sudhanshuksingh/Arduino-28-Pins-PCB/README.md

# Arduino-28-Pins-PCB
Contains all the important files related to my open source Arduino 28 Pins PCB Design Course
