sudhanshuksingh/Arduino-28-Pins-PCB/Certificate of Completion.pdf

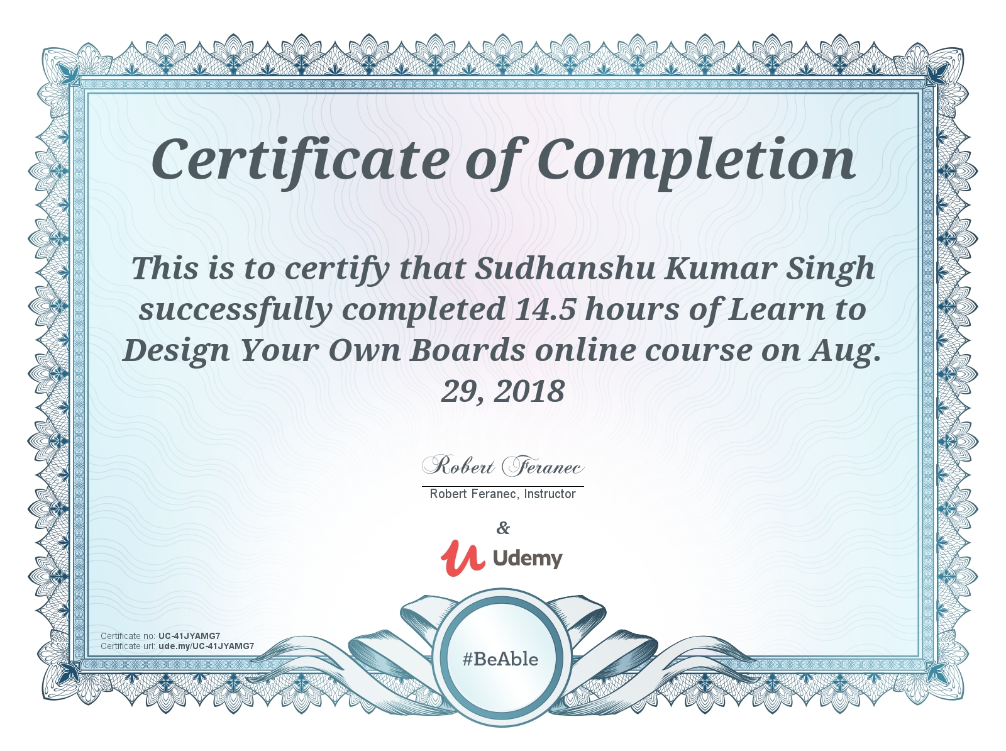
[picture p1: page 1]
