sudhanshuksingh/Arduino-28-Pins-PCB/Project Outputs for 28Pins_Project_V1I1/BOM/BOM Grouped Reference - 28Pins V1I1 FIXED 5V.xlsx

Sheet: Part List Report
 | Component reference list (grouped) |  |  |  | <Parameter Project not found>
 | Source Data From: |  | 28Pins_Project_V1I1.PrjPCB |  |  | Contact: |  | Generated by:
 | Project: |  | 28Pins_Project_V1I1.PrjPCB
 | Variant: |  | FIXED 5V |  |  |  |  | FEDEVEL
 | Report Date: |  | 29-08-2018 | 16:36:12 |  |  |  | http://www.fedevel.com
 | Print Date: |  | 2018-08-29 | 16:36:29
# | Designator | Quantity | Comment | Description | Manufacturer 1 | Manufacturer Part Number 1 | Case/Package | Supplier 1 | Supplier Part Number 1
1 | C1, C2 | 2 | 100u / 10V | Cap Aluminum Lytic 100uF 10V 20% (5 X 5.4mm) SMD 50mA 1000h 85C Automotive T/R | Panasonic (https://octopart-clicks.com/click/altium?sku=PCE3867CT-ND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) | EEE-1AA101WR (https://octopart-clicks.com/click/altium?sku=PCE3867CT-ND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) | Radial | Digi-Key | PCE3867CT-ND (https://octopart-clicks.com/click/altium?sku=PCE3867CT-ND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)
2 | C3, C12, C13, C19, C21, C22, C34 | 7 | 10uF / 16V | CAP CER 10UF 16V X5R 0805 | TDK (https://octopart-clicks.com/click/altium?sku=445-4115-1-ND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) | C2012X5R1C106M125AC (https://octopart-clicks.com/click/altium?sku=445-4115-1-ND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) | 0805 | Digi-Key | 445-4115-1-ND (https://octopart-clicks.com/click/altium?sku=445-4115-1-ND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)
3 | C4, C5, C6, C8, C11, C14, C15, C16, C17, C20, C23, C24, C26, C28, C29, C30, C31, C32, C33 | 19 | 100n | CAP CER 0.1UF 50V X7R 0805 | TDK (https://octopart-clicks.com/click/altium?sku=445-7534-1-ND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) | C2012X7R1H104K085AA (https://octopart-clicks.com/click/altium?sku=445-7534-1-ND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) | 0805 | Digi-Key | 445-7534-1-ND (https://octopart-clicks.com/click/altium?sku=445-7534-1-ND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)
4 | C7 | 1 | 1uf / 25V | CAP CER 1UF 25V X5R 0805 | TDK (https://octopart-clicks.com/click/altium?sku=445-1419-1-ND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) | C2012X5R1E105K125AA (https://octopart-clicks.com/click/altium?sku=445-1419-1-ND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) | 0805 | Digi-Key | 445-1419-1-ND (https://octopart-clicks.com/click/altium?sku=445-1419-1-ND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)
5 | C9, C10, C25, C27 | 4 | 18p | CAP CER 18PF 50V NP0 0805 | KEMET (https://octopart-clicks.com/click/altium?sku=399-1112-1-ND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) | C0805C180J5GAC-TU (https://octopart-clicks.com/click/altium?sku=399-1112-1-ND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) | 0805 | Digi-Key | 399-1112-1-ND (https://octopart-clicks.com/click/altium?sku=399-1112-1-ND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)
6 | D1 | 1 | Green | LED GREEN DIFFUSED 0603 SMD | Osram Opto (https://octopart-clicks.com/click/altium?sku=475-2709-1-ND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) | Q65110A1746 (https://octopart-clicks.com/click/altium?sku=475-2709-1-ND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) | 0603 | Digi-Key | 475-2709-1-ND (https://octopart-clicks.com/click/altium?sku=475-2709-1-ND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)
7 | D2, D3, D4 | 3 | Orange | LED ORANGE DIFFUSED 0603 SMD | Osram Opto (https://octopart-clicks.com/click/altium?sku=475-2740-1-ND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) | Q65110A1747 (https://octopart-clicks.com/click/altium?sku=475-2740-1-ND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) | 0603 | Digi-Key | 475-2740-1-ND (https://octopart-clicks.com/click/altium?sku=475-2740-1-ND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)
8 | D5, D6 | 2 | BAT54HT1G | DIODE SCHOTTKY 30V 200MA SOD323 | ON Semiconductor (https://octopart-clicks.com/click/altium?sku=BAT54HT1GOSCT-ND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) | BAT54HT1G.. (https://octopart-clicks.com/click/altium?sku=BAT54HT1GOSCT-ND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) |  | Digi-Key | BAT54HT1GOSCT-ND (https://octopart-clicks.com/click/altium?sku=BAT54HT1GOSCT-ND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)
9 | FB1, FB2, FB3 | 3 | MPZ2012S601AT000 | TDK MPZ2012S601AT000 FERRITE BEAD, 0.1OHM, 2A, 0805, FULL REEL | TDK (https://octopart-clicks.com/click/altium?sku=445-2206-1-ND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) | MPZ2012S601AT000 (https://octopart-clicks.com/click/altium?sku=445-2206-1-ND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) | 0805 | Digi-Key | 445-2206-1-ND (https://octopart-clicks.com/click/altium?sku=445-2206-1-ND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)
10 | J1, J3 | 2 | HDR FMALE 1x8 2.54mm | Headers & Wire Housings 8 PIN SIL VERTICAL SOCKET GOLD+TIN | Harwin (https://octopart-clicks.com/click/altium?sku=952-1823-ND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) | M20-7820842 (https://octopart-clicks.com/click/altium?sku=952-1823-ND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) | SIL | Digi-Key | 952-1823-ND (https://octopart-clicks.com/click/altium?sku=952-1823-ND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)
11 | J2 | 1 | HDE FMALE 1x6 2.54mm | Headers & Wire Housings 6 PIN SIL VERTICAL SOCKET TIN | Harwin (https://octopart-clicks.com/click/altium?sku=952-1809-ND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) | M20-7820646 (https://octopart-clicks.com/click/altium?sku=952-1809-ND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) | SIL | Digi-Key | 952-1809-ND (https://octopart-clicks.com/click/altium?sku=952-1809-ND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)
12 | J4 | 1 | HDR FMALE 1x10 2.54mm | Headers & Wire Housings 10 PIN SIL VERTICAL SOCKET TIN | Harwin (https://octopart-clicks.com/click/altium?sku=952-1847-ND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) | M20-7821046 (https://octopart-clicks.com/click/altium?sku=952-1847-ND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) | SIL | Digi-Key | 952-1847-ND (https://octopart-clicks.com/click/altium?sku=952-1847-ND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)
13 | J5, J6 | 2 | HDR 2x3 | 6 Positions Header, Unshrouded Connector 0.100" (2.54mm) Through Hole Gold or Gold, GXT™ | Amphenol FCI (https://octopart-clicks.com/click/altium?sku=609-3393-ND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) | 67997-106HLF (https://octopart-clicks.com/click/altium?sku=609-3393-ND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) |  | Digi-Key | 609-3393-ND (https://octopart-clicks.com/click/altium?sku=609-3393-ND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)
14 | J7 | 1 | 10118193-0001LF | USB - micro B USB 2.0 Receptacle Connector 5 Position Surface Mount, Right Angle, Horizontal | Amphenol FCI (https://octopart-clicks.com/click/altium?sku=609-4616-1-ND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) | 10118193-0001LF (https://octopart-clicks.com/click/altium?sku=609-4616-1-ND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) |  | Digi-Key | 609-4616-1-ND (https://octopart-clicks.com/click/altium?sku=609-4616-1-ND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)
15 | JP1 | 1 | HDR 1x3 | 3 Positions Header, Unshrouded Connector 0.100" (2.54mm) Through Hole Gold or Gold, GXT™ | Amphenol FCI (https://octopart-clicks.com/click/altium?sku=609-3461-ND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) | 68000-103HLF (https://octopart-clicks.com/click/altium?sku=609-3461-ND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) |  | Digi-Key | 609-3461-ND (https://octopart-clicks.com/click/altium?sku=609-3461-ND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)
16 | JP3 | 1 | HDR 1x4 | 4 Positions Header, Unshrouded Connector 0.100" (2.54mm) Through Hole Gold or Gold, GXT™ | Amphenol FCI (https://octopart-clicks.com/click/altium?sku=609-3402-ND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) | 68001-204HLF (https://octopart-clicks.com/click/altium?sku=609-3402-ND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) |  | Digi-Key | 609-3402-ND (https://octopart-clicks.com/click/altium?sku=609-3402-ND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)
17 | L1 | 1 | 2u2 / 2A | Inductor Chip Wirewound 2.2uH 20% 100KHz 1.13A 80mOhm DCR 1210 T/R | KEMET (https://octopart-clicks.com/click/altium?sku=399-9598-1-ND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) | L1210R2R2MDWIT (https://octopart-clicks.com/click/altium?sku=399-9598-1-ND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) | 1210 | Digi-Key | 399-9598-1-ND (https://octopart-clicks.com/click/altium?sku=399-9598-1-ND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)
18 | LINK1, LINK2 | 2 | LINK | CONN JUMPER SHORTING .100" GOLD | Sullins (https://octopart-clicks.com/click/altium?sku=S9337-ND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) | QPC02SXGN-RC (https://octopart-clicks.com/click/altium?sku=S9337-ND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) | 100 | Digi-Key | S9337-ND (https://octopart-clicks.com/click/altium?sku=S9337-ND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)
19 | R1 | 1 | 100k | RES SMD 100K OHM 1% 1/8W 0805 | Yageo (https://octopart-clicks.com/click/altium?sku=YAG3359CT-ND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) | RT0805FRE07100KL (https://octopart-clicks.com/click/altium?sku=YAG3359CT-ND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) | 0805 | Digi-Key | YAG3359CT-ND (https://octopart-clicks.com/click/altium?sku=YAG3359CT-ND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)
20 | R2, R3, R15, R17, R22 | 5 | 560R | RES SMD 560 OHM 1% 1/8W 0805 | Yageo Phycomp (https://octopart-clicks.com/click/altium?sku=311-560CRCT-ND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) | RC0805FR-07560RL (https://octopart-clicks.com/click/altium?sku=311-560CRCT-ND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) | 0805 | Digi-Key | 311-560CRCT-ND (https://octopart-clicks.com/click/altium?sku=311-560CRCT-ND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)
21 | R4, R14, R18, R19, R20, R21 | 6 | 10k | RES SMD 10K OHM 1% 1/8W 0805 | Yageo (https://octopart-clicks.com/click/altium?sku=311-10.0KCRCT-ND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) | RC0805FR-0710KL (https://octopart-clicks.com/click/altium?sku=311-10.0KCRCT-ND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) | 0805 | Digi-Key | 311-10.0KCRCT-ND (https://octopart-clicks.com/click/altium?sku=311-10.0KCRCT-ND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)
22 | R5, R6, R7, R13, R23, R24, R25 | 7 | 22R | RES SMD 22 OHM 1% 1/8W 0805 | Yageo (https://octopart-clicks.com/click/altium?sku=311-22.0CRCT-ND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) | RC0805FR-0722RL (https://octopart-clicks.com/click/altium?sku=311-22.0CRCT-ND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) | 0805 | Digi-Key | 311-22.0CRCT-ND (https://octopart-clicks.com/click/altium?sku=311-22.0CRCT-ND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)
23 | R8, R27 | 2 | 0R | YAGEO RC0805JR-070RL RES, THICK FILM, 0R, 0.125W, 0805 | Yageo (https://octopart-clicks.com/click/altium?sku=311-0.0ARCT-ND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) | RC0805JR-070RL (https://octopart-clicks.com/click/altium?sku=311-0.0ARCT-ND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) | 0805 | Digi-Key | 311-0.0ARCT-ND (https://octopart-clicks.com/click/altium?sku=311-0.0ARCT-ND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)
24 | R9, R16 | 2 | 1M | Yageo RC0805 Series Thick Film Surface Mount Resistor 0805 Case 1MO ±1% 0.125W ±100ppm/°C | Yageo (https://octopart-clicks.com/click/altium?sku=311-1.00MCRCT-ND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) | RC0805FR-071ML (https://octopart-clicks.com/click/altium?sku=311-1.00MCRCT-ND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) | 0805 | Digi-Key | 311-1.00MCRCT-ND (https://octopart-clicks.com/click/altium?sku=311-1.00MCRCT-ND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)
25 | R10, R11, R12 | 3 | 1k | RES SMD 1K OHM 1% 1/8W 0805 | Yageo (https://octopart-clicks.com/click/altium?sku=311-1.00KCRCT-ND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) | RC0805FR-071KL (https://octopart-clicks.com/click/altium?sku=311-1.00KCRCT-ND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) | 0805 | Digi-Key | 311-1.00KCRCT-ND (https://octopart-clicks.com/click/altium?sku=311-1.00KCRCT-ND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)
26 | SCKT FOR U1 | 1 | 28-DIP Socket | SOCKET IC OPEN FRAME 28POS .3" | 3M (https://octopart-clicks.com/click/altium?sku=3M5480-ND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) | 4828-3004-CP (https://octopart-clicks.com/click/altium?sku=3M5480-ND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) |  | Digi-Key | 3M5480-ND (https://octopart-clicks.com/click/altium?sku=3M5480-ND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)
27 | SW1, SW2 | 2 | 1825910-6 | Switch Push Button OFF (ON) SPST Round Button 0.05A 24VDC Momentary Contact PC Pins Thru-Hole | TE Connectivity Alcoswitch (https://octopart-clicks.com/click/altium?manufacturer=TE%20Connectivity%20Alcoswitch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) | 1825910-6 (https://octopart-clicks.com/click/altium?manufacturer=TE%20Connectivity%20Alcoswitch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) |  | Digi-Key | 450-1650-ND (https://octopart-clicks.com/click/altium?manufacturer=TE%20Connectivity%20Alcoswitch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)
28 | U1 | 1 | ATMEGA328P-PU | ATMEL ATMEGA328P-PU 8 Bit Microcontroller, Low Power High Performance, ATmega, 20 MHz, 32 KB, 2 KB, 28 Pins, DIP | Microchip (https://octopart-clicks.com/click/altium?sku=ATMEGA328P-PU-ND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) | ATMEGA328P-PU (https://octopart-clicks.com/click/altium?sku=ATMEGA328P-PU-ND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) | PDIP | Digi-Key | ATMEGA328P-PU-ND (https://octopart-clicks.com/click/altium?sku=ATMEGA328P-PU-ND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)
29 | U2 | 1 | ATMEGA16U2-AU | ATMEL ATMEGA16U2-AU MCU, 8BIT, MEGAAVR, 16MHZ, TQFP-32 | Microchip (https://octopart-clicks.com/click/altium?sku=ATMEGA16U2-AU-ND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) | ATMEGA16U2-AU (https://octopart-clicks.com/click/altium?sku=ATMEGA16U2-AU-ND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) | A | Digi-Key | ATMEGA16U2-AU-ND (https://octopart-clicks.com/click/altium?sku=ATMEGA16U2-AU-ND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)
30 | U3 | 1 | TL1963A-33DCQR | IC REG LDO 3.3V 1.5A SOT223-6 | Texas Instruments (https://octopart-clicks.com/click/altium?sku=296-24534-1-ND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) | TL1963A-33DCQR (https://octopart-clicks.com/click/altium?sku=296-24534-1-ND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) | SOT-223 | Digi-Key | 296-24534-1-ND (https://octopart-clicks.com/click/altium?sku=296-24534-1-ND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)
31 | U4, U5, U6, U7 | 4 | SN74AHC1G09DBVR | IC GATE AND 1CH 2-INP SOT-23-5 | Texas Instruments (https://octopart-clicks.com/click/altium?sku=296-29202-1-ND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) | SN74AHC1G09DBVR (https://octopart-clicks.com/click/altium?sku=296-29202-1-ND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) | SOT-23 | Digi-Key | 296-29202-1-ND (https://octopart-clicks.com/click/altium?sku=296-29202-1-ND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)
32 | Y1, Y2 | 2 | ABM7-16.000MHZ-D2Y-T | Crystals 16.0MHz 20ppm 18pF -40C+85C | Abracon (https://octopart-clicks.com/click/altium?sku=535-9840-1-ND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) | ABM7-16.000MHZ-D2Y-T (https://octopart-clicks.com/click/altium?sku=535-9840-1-ND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) | CSMD | Digi-Key | 535-9840-1-ND (https://octopart-clicks.com/click/altium?sku=535-9840-1-ND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)
33 | Z1, Z2 | 2 | CG0603MLC-05E | BOURNS CG0603MLC-05E TVS Varistor, AEC-Q200 ChipGuard MLC Series, 8 V, 5 V, 20 V, 0603 [1608 Metric], ESD Protector | Bourns (https://octopart-clicks.com/click/altium?sku=CG0603MLC-05ECT-ND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) | CG0603MLC-05E (https://octopart-clicks.com/click/altium?sku=CG0603MLC-05ECT-ND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) | 0603 | Digi-Key | CG0603MLC-05ECT-ND (https://octopart-clicks.com/click/altium?sku=CG0603MLC-05ECT-ND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)
Approved |  |  |  |  | Notes

Sheet: Project Information
Project Full Path | C:\Users\admin\Downloads\Altium Design Course\Udemy\28 Pins\Design Files\V1I1\28Pins_Project_V1I1.PrjPCB
Project Filename | 28Pins_Project_V1I1.PrjPCB
Variant Name | FIXED 5V
Data-Source Filename | 28Pins_Project_V1I1.PrjPCB
Data-Source Full Path | C:\Users\admin\Downloads\Altium Design Course\Udemy\28 Pins\Design Files\V1I1\28Pins_Project_V1I1.PrjPCB
Title | 28Pins_Project_V1I1.PrjPCB
Total Quantity | 94
Report Time | 16:36:12
Report Date | 29-08-2018
Report Date & Tine | 29-08-2018 16:36:12
Output Name | 28 Pins Component Grouped BOM
Output Type | BOM_PartType
Output Generator Name | BOM
Output Generator Description | Bill of Materials
