sudhanshuksingh/Arduino-28-Pins-PCB/Project Outputs for 28Pins_Project_V1I1/BOM/BOM Purchasing - 28Pins V1I1 - 5V and 3V3.xls

Sheet: Part List Report
 | Component list |  |  | 28Pins BOM Purchasing For Variant [5V/3V3] of Project [28Pins_Project_V1I1.PrjPCB] (No PCB Document Selected)
 | Source Data From: | 28Pins_Project_V1I1.PrjPCB |  |  | Contact: |  |  |  | Generated by:
 | Project: | 28Pins_Project_V1I1.PrjPCB
 | Variant: | 5V/3V3 |  |  |  |  |  |  | FEDEVEL
 | Report Date: | 29-08-2018 | 15:41:09 |  |  |  |  |  | http://www.fedevel.com
 | Print Date: | 2018-08-29 | 15:45:27
# | #Column Name Error:Category | Manufacturer 1 | Manufacturer Part Number 1 | #Column Name Error:Package / Case | Description | Quantity | Supplier 1 | Supplier Part Number 1 | Supplier Order Qty 1 | Supplier Stock 1 | Supplier Unit Price 1 | Supplier Subtotal 1 | Supplier Currency 1
1 |  | Amphenol FCI (https://octopart-clicks.com/click/altium?sku=609-3461-ND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) | 68000-103HLF (https://octopart-clicks.com/click/altium?sku=609-3461-ND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) |  | 3 Positions Header, Unshrouded Connector 0.100" (2.54mm) Through Hole Gold or Gold, GXT™ | 2 | Digi-Key | 609-3461-ND (https://octopart-clicks.com/click/altium?sku=609-3461-ND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) | 2000 | 27050 | 0.14 | 270.56 | USD
2 |  | Amphenol FCI (https://octopart-clicks.com/click/altium?sku=609-3402-ND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) | 68001-204HLF (https://octopart-clicks.com/click/altium?sku=609-3402-ND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) |  | 4 Positions Header, Unshrouded Connector 0.100" (2.54mm) Through Hole Gold or Gold, GXT™ | 1 | Digi-Key | 609-3402-ND (https://octopart-clicks.com/click/altium?sku=609-3402-ND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) | 1000 | 4106 | 0.17 | 173.60 | USD
3 |  | Amphenol FCI (https://octopart-clicks.com/click/altium?sku=609-3393-ND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) | 67997-106HLF (https://octopart-clicks.com/click/altium?sku=609-3393-ND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) |  | 6 Positions Header, Unshrouded Connector 0.100" (2.54mm) Through Hole Gold or Gold, GXT™ | 2 | Digi-Key | 609-3393-ND (https://octopart-clicks.com/click/altium?sku=609-3393-ND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) | 2000 | 1091 | 0.96 | 1919.40 | USD
4 |  | Abracon (https://octopart-clicks.com/click/altium?sku=535-9831-1-ND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) | ABM7-8.000MHZ-D2Y-T (https://octopart-clicks.com/click/altium?sku=535-9831-1-ND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) |  | ABRACON ABM7-8.000MHZ-D2Y-T CRYSTAL, 8MHZ, 18PF, SMD | 1 | Digi-Key | 535-9831-1-ND (https://octopart-clicks.com/click/altium?sku=535-9831-1-ND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) | 1000 | 8705 | 0.50 | 495.00 | USD
5 |  | Microchip (https://octopart-clicks.com/click/altium?sku=ATMEGA16U2-AU-ND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) | ATMEGA16U2-AU (https://octopart-clicks.com/click/altium?sku=ATMEGA16U2-AU-ND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) |  | ATMEL ATMEGA16U2-AU MCU, 8BIT, MEGAAVR, 16MHZ, TQFP-32 | 1 | Digi-Key | ATMEGA16U2-AU-ND (https://octopart-clicks.com/click/altium?sku=ATMEGA16U2-AU-ND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) | 1000 | 4678 | 2.10 | 2101.20 | USD
6 |  | Microchip (https://octopart-clicks.com/click/altium?sku=ATMEGA328P-PU-ND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) | ATMEGA328P-PU (https://octopart-clicks.com/click/altium?sku=ATMEGA328P-PU-ND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) |  | ATMEL ATMEGA328P-PU 8 Bit Microcontroller, Low Power High Performance, ATmega, 20 MHz, 32 KB, 2 KB, 28 Pins, DIP | 1 | Digi-Key | ATMEGA328P-PU-ND (https://octopart-clicks.com/click/altium?sku=ATMEGA328P-PU-ND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) | 1000 | 13456 | 1.78 | 1781.90 | USD
7 |  | Bourns (https://octopart-clicks.com/click/altium?sku=CG0603MLC-05ECT-ND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) | CG0603MLC-05E (https://octopart-clicks.com/click/altium?sku=CG0603MLC-05ECT-ND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) |  | BOURNS CG0603MLC-05E TVS Varistor, AEC-Q200 ChipGuard MLC Series, 8 V, 5 V, 20 V, 0603 [1608 Metric], ESD Protector | 2 | Digi-Key | CG0603MLC-05ECT-ND (https://octopart-clicks.com/click/altium?sku=CG0603MLC-05ECT-ND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) | 2000 | 187340 | 0.11 | 214.24 | USD
8 |  | Panasonic (https://octopart-clicks.com/click/altium?sku=PCE3867CT-ND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) | EEE-1AA101WR (https://octopart-clicks.com/click/altium?sku=PCE3867CT-ND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) |  | Cap Aluminum Lytic 100uF 10V 20% (5 X 5.4mm) SMD 50mA 1000h 85C Automotive T/R | 2 | Digi-Key | PCE3867CT-ND (https://octopart-clicks.com/click/altium?sku=PCE3867CT-ND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) | 2000 | 372 | 0.10 | 209.24 | USD
9 |  | TDK (https://octopart-clicks.com/click/altium?sku=445-7534-1-ND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) | C2012X7R1H104K085AA (https://octopart-clicks.com/click/altium?sku=445-7534-1-ND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) |  | CAP CER 0.1UF 50V X7R 0805 | 19 | Digi-Key | 445-7534-1-ND (https://octopart-clicks.com/click/altium?sku=445-7534-1-ND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) | 19000 | 0 | 0.03 | 482.79 | USD
10 |  | TDK (https://octopart-clicks.com/click/altium?sku=445-1419-1-ND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) | C2012X5R1E105K125AA (https://octopart-clicks.com/click/altium?sku=445-1419-1-ND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) |  | CAP CER 1UF 25V X5R 0805 | 1 | Digi-Key | 445-1419-1-ND (https://octopart-clicks.com/click/altium?sku=445-1419-1-ND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) | 1000 | 20000 | 0.04 | 39.93 | USD
11 |  | TDK (https://octopart-clicks.com/click/altium?sku=445-4115-1-ND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) | C2012X5R1C106M125AC (https://octopart-clicks.com/click/altium?sku=445-4115-1-ND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) |  | CAP CER 10UF 16V X5R 0805 | 7 | Digi-Key | 445-4115-1-ND (https://octopart-clicks.com/click/altium?sku=445-4115-1-ND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) | 7000 | 0 | 0.08 | 559.30 | USD
12 |  | KEMET (https://octopart-clicks.com/click/altium?sku=399-1112-1-ND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) | C0805C180J5GAC7800 (https://octopart-clicks.com/click/altium?sku=399-1112-1-ND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) |  | CAP CER 18PF 50V NP0 0805 | 4 | Digi-Key | 399-1112-1-ND (https://octopart-clicks.com/click/altium?sku=399-1112-1-ND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) | 4000 | 8 | 0.02 | 98.72 | USD
13 |  | Sullins (https://octopart-clicks.com/click/altium?sku=S9337-ND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) | QPC02SXGN-RC (https://octopart-clicks.com/click/altium?sku=S9337-ND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) |  | CONN JUMPER SHORTING .100" GOLD | 3 | Digi-Key | S9337-ND (https://octopart-clicks.com/click/altium?sku=S9337-ND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) | 3000 | 568359 | 0.02 | 71.82 | USD
14 |  | Abracon (https://octopart-clicks.com/click/altium?sku=535-9833-1-ND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) | ABM7-10.000MHZ-D2Y-T (https://octopart-clicks.com/click/altium?sku=535-9833-1-ND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) |  | Crystal 10MHz 18pF 2-Pin SMD T/R | 1 | Digi-Key | 535-9833-1-ND (https://octopart-clicks.com/click/altium?sku=535-9833-1-ND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) | 1000 | 16216 | 0.69 | 693.00 | USD
15 |  | ON Semiconductor (https://octopart-clicks.com/click/altium?sku=BAT54HT1GOSCT-ND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) | BAT54HT1G.. (https://octopart-clicks.com/click/altium?sku=BAT54HT1GOSCT-ND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) |  | DIODE SCHOTTKY 30V 200MA SOD323 | 2 | Digi-Key | BAT54HT1GOSCT-ND (https://octopart-clicks.com/click/altium?sku=BAT54HT1GOSCT-ND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) | 2000 | 187816 | 0.05 | 106.92 | USD
16 |  | Harwin (https://octopart-clicks.com/click/altium?sku=952-1809-ND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) | M20-7820646 (https://octopart-clicks.com/click/altium?sku=952-1809-ND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) |  | Headers & Wire Housings 6 PIN SIL VERTICAL SOCKET TIN | 1 | Digi-Key | 952-1809-ND (https://octopart-clicks.com/click/altium?sku=952-1809-ND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) | 1000 | 3664 | 0.59 | 594.01 | USD
17 |  | Harwin (https://octopart-clicks.com/click/altium?sku=952-1823-ND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) | M20-7820842 (https://octopart-clicks.com/click/altium?sku=952-1823-ND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) |  | Headers & Wire Housings 8 PIN SIL VERTICAL SOCKET GOLD+TIN | 2 | Digi-Key | 952-1823-ND (https://octopart-clicks.com/click/altium?sku=952-1823-ND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) | 2000 | 1517 | 0.61 | 1219.20 | USD
18 |  | Harwin (https://octopart-clicks.com/click/altium?sku=952-1847-ND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) | M20-7821046 (https://octopart-clicks.com/click/altium?sku=952-1847-ND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) |  | Headers & Wire Housings 10 PIN SIL VERTICAL SOCKET TIN | 1 | Digi-Key | 952-1847-ND (https://octopart-clicks.com/click/altium?sku=952-1847-ND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) | 1000 | 298 | 0.79 | 792.00 | USD
19 |  | Texas Instruments (https://octopart-clicks.com/click/altium?sku=296-29202-1-ND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) | SN74AHC1G09DBVR (https://octopart-clicks.com/click/altium?sku=296-29202-1-ND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) |  | IC GATE AND 1CH 2-INP SOT-23-5 | 4 | Digi-Key | 296-29202-1-ND (https://octopart-clicks.com/click/altium?sku=296-29202-1-ND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) | 4000 | 65971 | 0.11 | 420.24 | USD
20 |  | Texas Instruments (https://octopart-clicks.com/click/altium?sku=296-24534-1-ND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) | TL1963A-33DCQR (https://octopart-clicks.com/click/altium?sku=296-24534-1-ND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) |  | IC REG LDO 3.3V 1.5A SOT223-6 | 1 | Digi-Key | 296-24534-1-ND (https://octopart-clicks.com/click/altium?sku=296-24534-1-ND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) | 1000 | 0 | 1.52 | 1522.75 | USD
21 |  | KEMET (https://octopart-clicks.com/click/altium?sku=399-9598-1-ND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) | L1210R2R2MDWIT (https://octopart-clicks.com/click/altium?sku=399-9598-1-ND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) |  | Inductor Chip Wirewound 2.2uH 20% 100KHz 1.13A 80mOhm DCR 1210 T/R | 1 | Digi-Key | 399-9598-1-ND (https://octopart-clicks.com/click/altium?sku=399-9598-1-ND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) | 1000 | 4164 | 0.29 | 287.38 | USD
22 |  | Osram Opto (https://octopart-clicks.com/click/altium?sku=475-2709-1-ND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) | Q65110A1746 (https://octopart-clicks.com/click/altium?sku=475-2709-1-ND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) |  | LED GREEN DIFFUSED 0603 SMD | 1 | Digi-Key | 475-2709-1-ND (https://octopart-clicks.com/click/altium?sku=475-2709-1-ND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) | 1000 | 589358 | 0.15 | 148.12 | USD
23 |  | Osram Opto (https://octopart-clicks.com/click/altium?sku=475-2740-1-ND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) | Q65110A1747 (https://octopart-clicks.com/click/altium?sku=475-2740-1-ND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) |  | LED ORANGE DIFFUSED 0603 SMD | 3 | Digi-Key | 475-2740-1-ND (https://octopart-clicks.com/click/altium?sku=475-2740-1-ND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) | 3000 | 10942 | 0.12 | 353.82 | USD
24 |  | Yageo (https://octopart-clicks.com/click/altium?sku=311-1.00KCRCT-ND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) | RC0805FR-071KL (https://octopart-clicks.com/click/altium?sku=311-1.00KCRCT-ND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) |  | RES SMD 1K OHM 1% 1/8W 0805 | 3 | Digi-Key | 311-1.00KCRCT-ND (https://octopart-clicks.com/click/altium?sku=311-1.00KCRCT-ND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) | 3000 | 2399055 | 0.01 | 21.75 | USD
25 |  | Yageo (https://octopart-clicks.com/click/altium?sku=311-10.0KCRCT-ND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) | RC0805FR-0710KL (https://octopart-clicks.com/click/altium?sku=311-10.0KCRCT-ND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) |  | RES SMD 10K OHM 1% 1/8W 0805 | 6 | Digi-Key | 311-10.0KCRCT-ND (https://octopart-clicks.com/click/altium?sku=311-10.0KCRCT-ND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) | 6000 | 0 | 0.01 | 43.50 | USD
26 |  | Yageo (https://octopart-clicks.com/click/altium?sku=311-22.0CRCT-ND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) | RC0805FR-0722RL (https://octopart-clicks.com/click/altium?sku=311-22.0CRCT-ND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) |  | RES SMD 22 OHM 1% 1/8W 0805 | 7 | Digi-Key | 311-22.0CRCT-ND (https://octopart-clicks.com/click/altium?sku=311-22.0CRCT-ND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) | 7000 | 545224 | 0.01 | 50.75 | USD
27 |  | Yageo (https://octopart-clicks.com/click/altium?sku=YAG3359CT-ND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) | RT0805FRE07100KL (https://octopart-clicks.com/click/altium?sku=YAG3359CT-ND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) |  | RES SMD 100K OHM 1% 1/8W 0805 | 1 | Digi-Key | YAG3359CT-ND (https://octopart-clicks.com/click/altium?sku=YAG3359CT-ND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) | 1000 | 41240 | 0.02 | 16.48 | USD
28 |  | Yageo (https://octopart-clicks.com/click/altium?sku=311-560CRCT-ND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) | RC0805FR-07560RL (https://octopart-clicks.com/click/altium?sku=311-560CRCT-ND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) |  | RES SMD 560 OHM 1% 1/8W 0805 | 5 | Digi-Key | 311-560CRCT-ND (https://octopart-clicks.com/click/altium?sku=311-560CRCT-ND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) | 5000 | 56450 | 0.01 | 36.25 | USD
29 |  | 3M (https://octopart-clicks.com/click/altium?sku=3M5480-ND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) | 4828-3004-CP (https://octopart-clicks.com/click/altium?sku=3M5480-ND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) |  | SOCKET IC OPEN FRAME 28POS .3" | 1 | Digi-Key | 3M5480-ND (https://octopart-clicks.com/click/altium?sku=3M5480-ND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) | 1000 | 14142 | 0.42 | 422.40 | USD
30 |  | TE Connectivity Alcoswitch (https://octopart-clicks.com/click/altium?manufacturer=TE%20Connectivity%20Alcoswitch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) | 1825910-6 (https://octopart-clicks.com/click/altium?manufacturer=TE%20Connectivity%20Alcoswitch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) |  | Switch Push Button OFF (ON) SPST Round Button 0.05A 24VDC Momentary Contact PC Pins Thru-Hole | 2 | Digi-Key | 450-1650-ND (https://octopart-clicks.com/click/altium?manufacturer=TE%20Connectivity%20Alcoswitch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) | 2000 | 28381 | 0.05 | 109.50 | USD
31 |  | TDK (https://octopart-clicks.com/click/altium?sku=445-2206-1-ND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) | MPZ2012S601AT000 (https://octopart-clicks.com/click/altium?sku=445-2206-1-ND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) |  | TDK MPZ2012S601AT000 FERRITE BEAD, 0.1OHM, 2A, 0805, FULL REEL | 3 | Digi-Key | 445-2206-1-ND (https://octopart-clicks.com/click/altium?sku=445-2206-1-ND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) | 3000 | 379218 | 0.03 | 90.60 | USD
32 |  | Amphenol FCI (https://octopart-clicks.com/click/altium?sku=609-4616-1-ND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) | 10118193-0001LF (https://octopart-clicks.com/click/altium?sku=609-4616-1-ND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) |  | USB - micro B USB 2.0 Receptacle Connector 5 Position Surface Mount, Right Angle, Horizontal | 1 | Digi-Key | 609-4616-1-ND (https://octopart-clicks.com/click/altium?sku=609-4616-1-ND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) | 1000 | 168951 | 0.31 | 309.66 | USD
33 |  | Yageo (https://octopart-clicks.com/click/altium?sku=311-0.0ARCT-ND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) | RC0805JR-070RL (https://octopart-clicks.com/click/altium?sku=311-0.0ARCT-ND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) |  | YAGEO RC0805JR-070RL RES, THICK FILM, 0R, 0.125W, 0805 | 1 | Digi-Key | 311-0.0ARCT-ND (https://octopart-clicks.com/click/altium?sku=311-0.0ARCT-ND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) | 1000 | 2665301 | 0.01 | 8.42 | USD
34 |  | Yageo (https://octopart-clicks.com/click/altium?sku=311-1.00MCRCT-ND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) | RC0805FR-071ML (https://octopart-clicks.com/click/altium?sku=311-1.00MCRCT-ND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) |  | Yageo RC0805 Series Thick Film Surface Mount Resistor 0805 Case 1MO ±1% 0.125W ±100ppm/°C | 2 | Digi-Key | 311-1.00MCRCT-ND (https://octopart-clicks.com/click/altium?sku=311-1.00MCRCT-ND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) | 2000 | 0 | 0.01 | 16.70 | USD
 |  |  |  |  |  | 95 |  |  | 95000 |  |  | 15681.15
Approved |  |  |  | Notes
 |  |  |  |  |  | 1000 | pcs: | Total |  | 15681.15 |  | USD
 |  |  |  |  |  |  |  | Price for 1pcs |  | 15.68 |  | USD

Sheet: Project Information
Project Full Path | C:\Users\admin\Downloads\Altium Design Course\Udemy\28 Pins\Design Files\V1I1\28Pins_Project_V1I1.PrjPCB
Project Filename | 28Pins_Project_V1I1.PrjPCB
Variant Name | 5V/3V3
Data-Source Filename | 28Pins_Project_V1I1.PrjPCB
Data-Source Full Path | C:\Users\admin\Downloads\Altium Design Course\Udemy\28 Pins\Design Files\V1I1\28Pins_Project_V1I1.PrjPCB
Title | 28Pins BOM Purchasing For Variant [5V/3V3] of Project [28Pins_Project_V1I1.PrjPCB] (No PCB Document Selected)
Total Quantity | 95
Report Time | 15:41:09
Report Date | 29-08-2018
Report Date & Tine | 29-08-2018 15:41:09
Output Name | 28Pins BOM Purchasing
Output Type | BOM_PartType
Output Generator Name | BOM
Output Generator Description | Bill of Materials
