sudhanshuksingh/Arduino-28-Pins-PCB/ABM7_1.STEP/ABM7.STEP

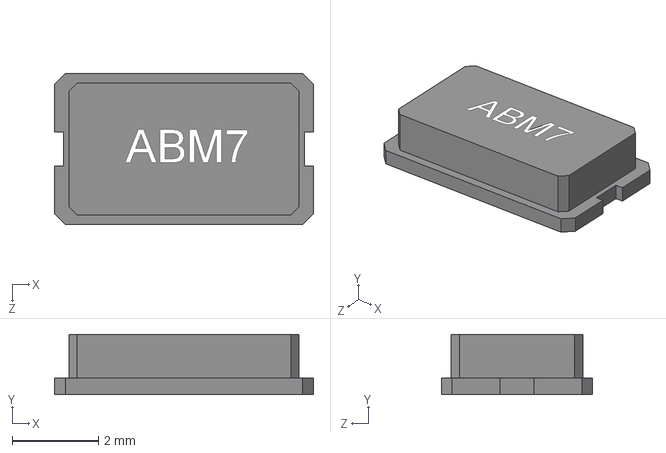
[picture p2: CAD file, 2018-08-29]
ABM7_1.STEP/ABM7.STEP
5.99 x 1.40 x 3.51 mm
