sudhanshuksingh/Arduino-28-Pins-PCB/User Library-SOD323.step

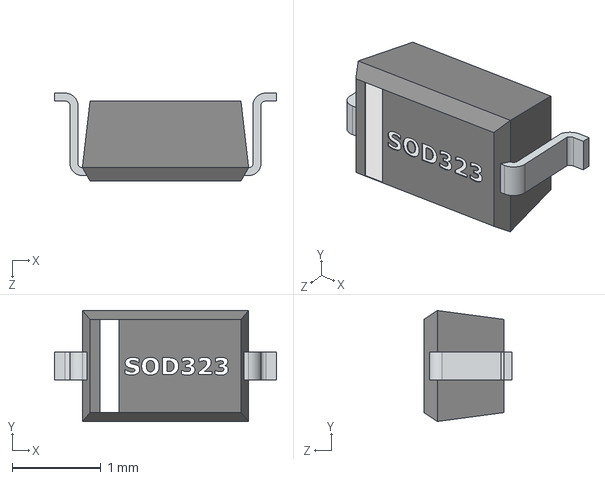
[picture p3: CAD file, 2018-08-29]
User Library-SOD323.step
2.50 x 1.25 x 0.99 mm
