sudhanshuksingh/Arduino-28-Pins-PCB/HDR_1x4_White.stp

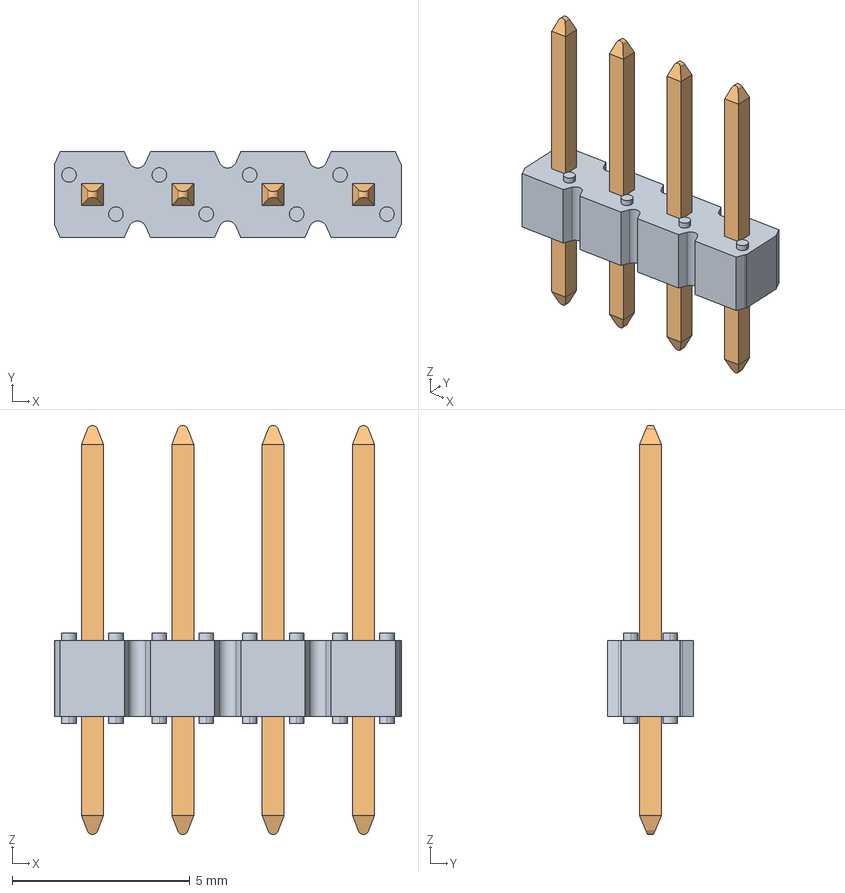
[picture p4: CAD file, 2018-08-29]
HDR_1x4_White.stp
9.76 x 2.41 x 11.5 mm
