sudhanshuksingh/Arduino-28-Pins-PCB/CAPC2012X145N EIA 0805.step

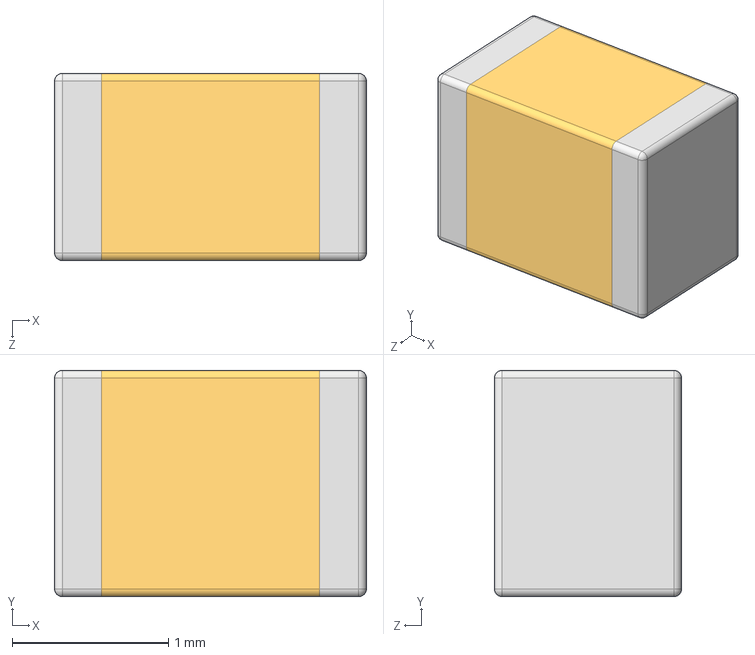
[picture p5: CAD file, 2018-08-29]
CAPC2012X145N EIA 0805.step
2.00 x 1.45 x 1.20 mm
