sudhanshuksingh/Arduino-28-Pins-PCB/User Library-LED SMD 0603 super red.step

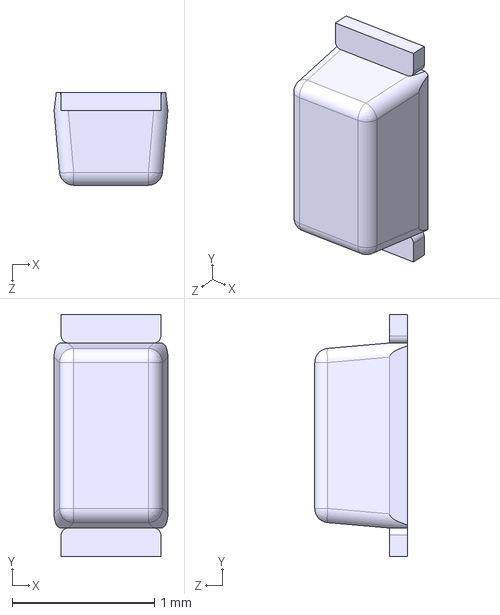
[picture p6: CAD file, 2018-08-29]
User Library-LED SMD 0603 super red.step
0.8 x 1.70 x 0.65 mm
