sudhanshuksingh/Arduino-28-Pins-PCB/R0603.step

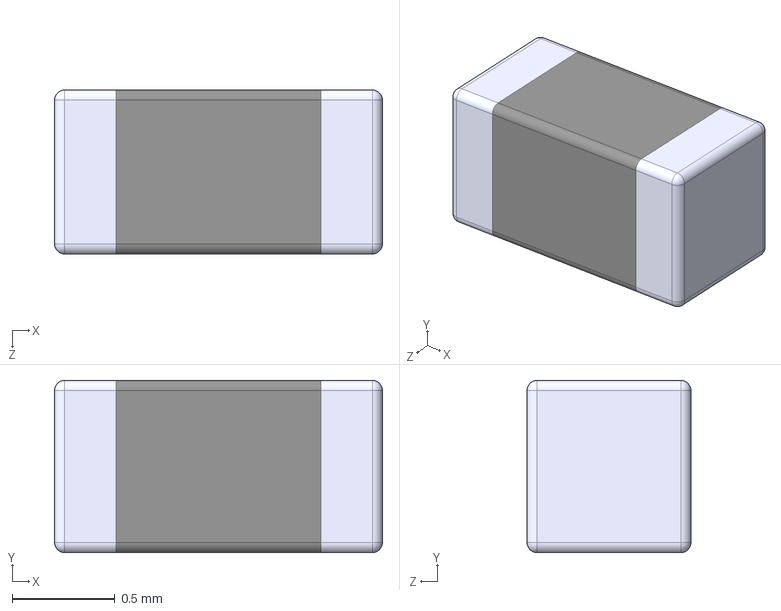
[picture p7: CAD file, 2018-08-29]
R0603.step
1.60 x 0.84 x 0.8 mm
