sudhanshuksingh/Arduino-28-Pins-PCB/User Library-TPS73701DCQ.step

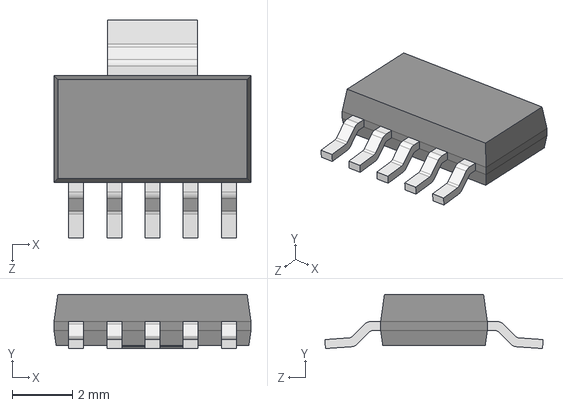
[picture p8: CAD file, 2018-08-29]
User Library-TPS73701DCQ.step
6.55 x 1.80 x 7.26 mm
