sudhanshuksingh/Arduino-28-Pins-PCB/dil_socket.stp

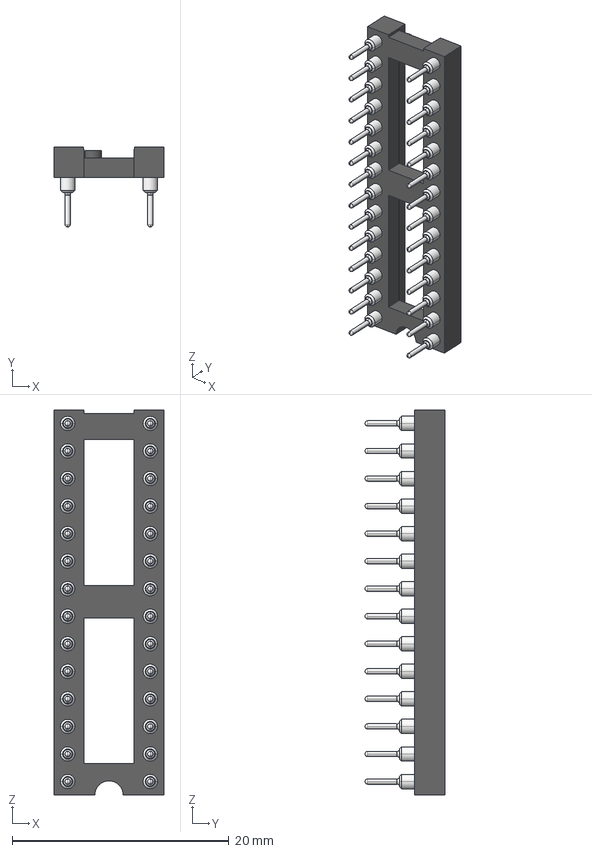
[picture p9: CAD file, 2018-08-29]
dil_socket.stp
10.1 x 7.37 x 35.5 mm
