sudhanshuksingh/Arduino-28-Pins-PCB/User Library-TPS79333DBVR.step

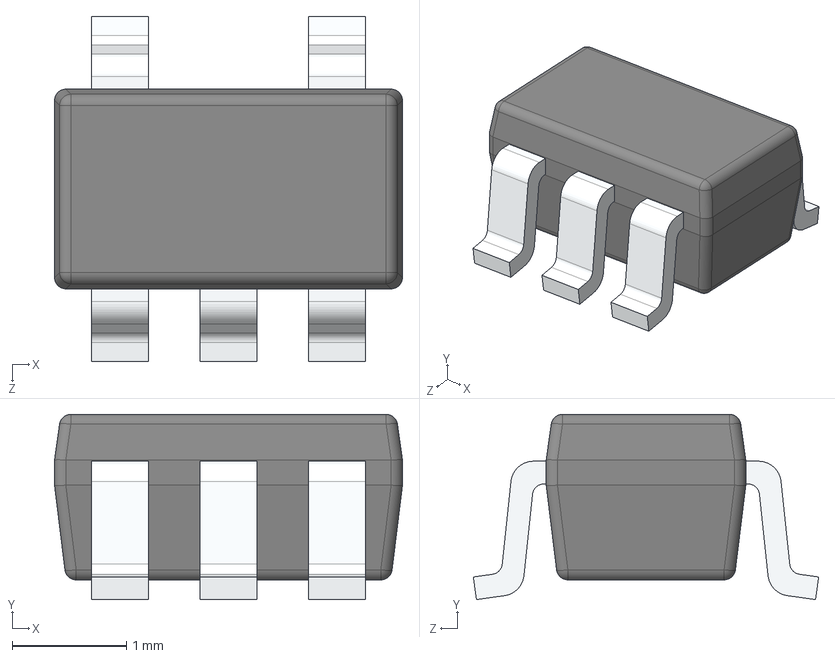
[picture p11: CAD file, 2018-08-29]
User Library-TPS79333DBVR.step
3.05 x 1.62 x 3.03 mm
