sudhanshuksingh/Arduino-28-Pins-PCB/User Library-28 pin dip.step

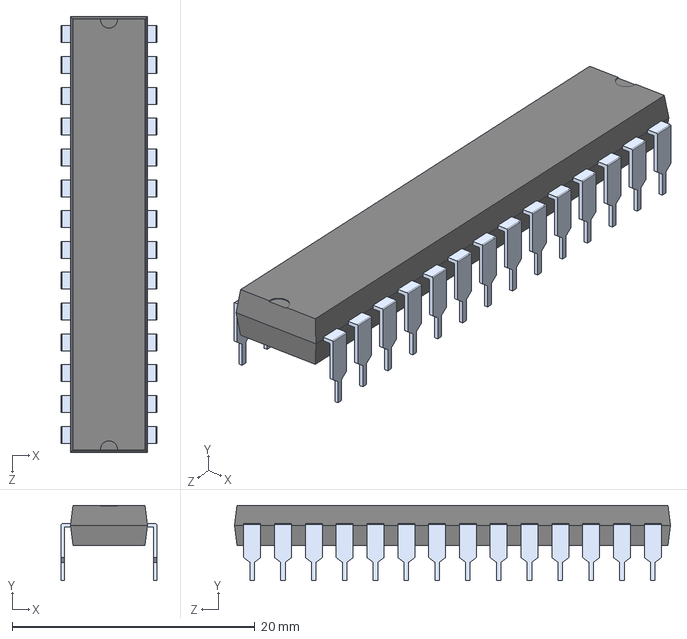
[picture p12: CAD file, 2018-08-29]
User Library-28 pin dip.step
7.87 x 6.22 x 35.9 mm
