sudhanshuksingh/Arduino-28-Pins-PCB/User Library-FSM4JLH(1825910-5).step

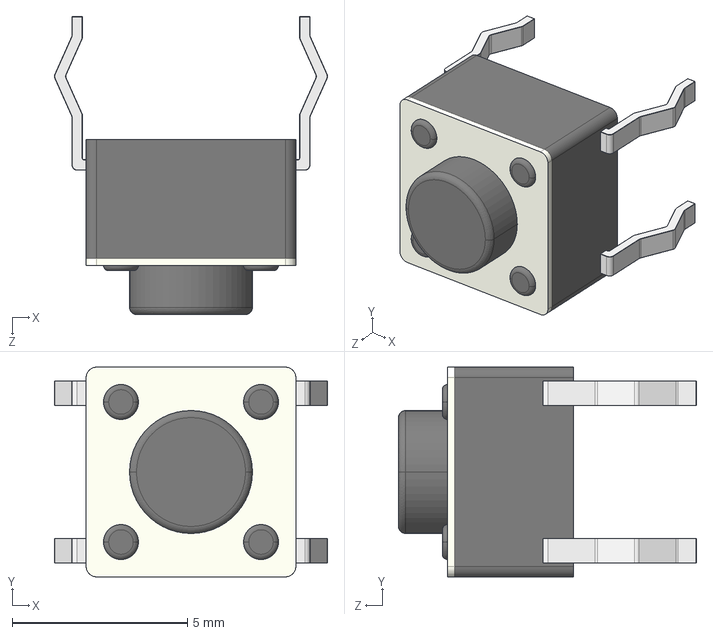
[picture p13: CAD file, 2018-08-29]
User Library-FSM4JLH(1825910-5).step
7.80 x 5.99 x 8.51 mm
