sudhanshuksingh/Arduino-28-Pins-PCB/HDR_1x3_White.stp

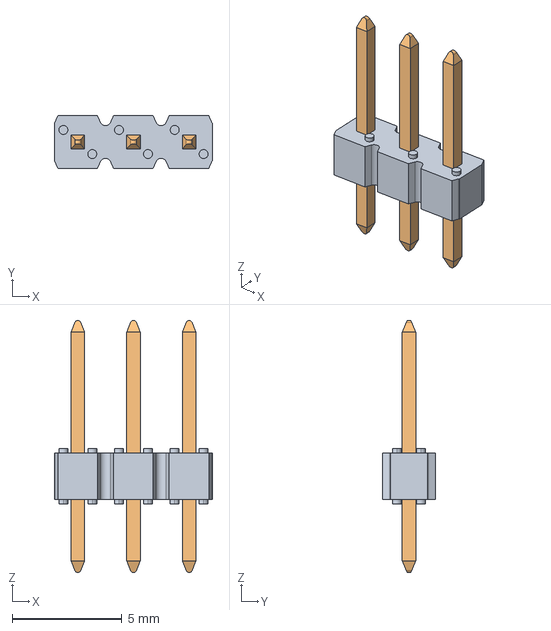
[picture p14: CAD file, 2018-08-29]
HDR_1x3_White.stp
7.22 x 2.41 x 11.5 mm
77310_Y16 x 3
