sudhanshuksingh/Arduino-28-Pins-PCB/User Library-Chip Resistor2RESC2012X70N.STEP

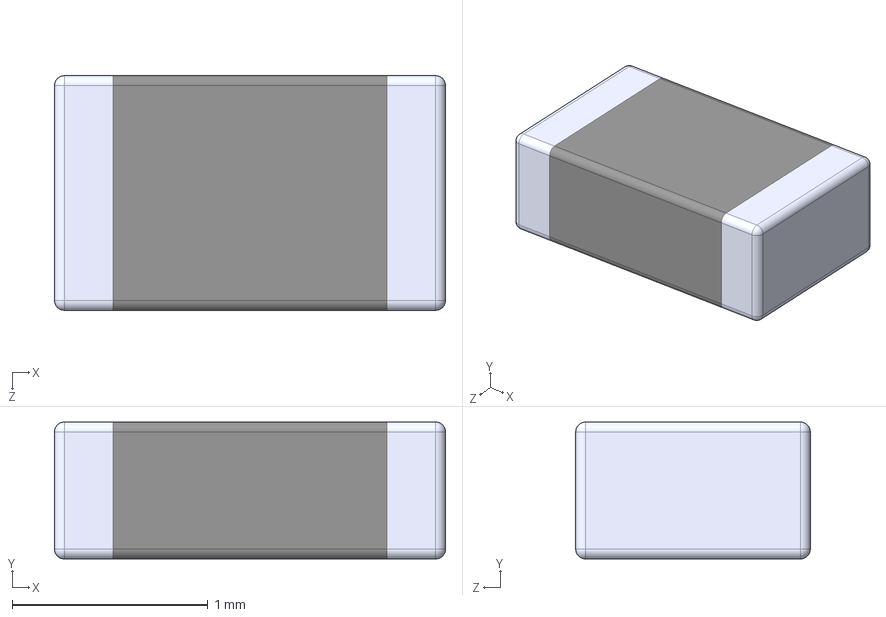
[picture p15: CAD file, 2018-08-29]
User Library-Chip Resistor2RESC2012X70N.STEP
2.00 x 0.7 x 1.20 mm
