sudhanshuksingh/Arduino-28-Pins-PCB/User Library-capacitor size C.step

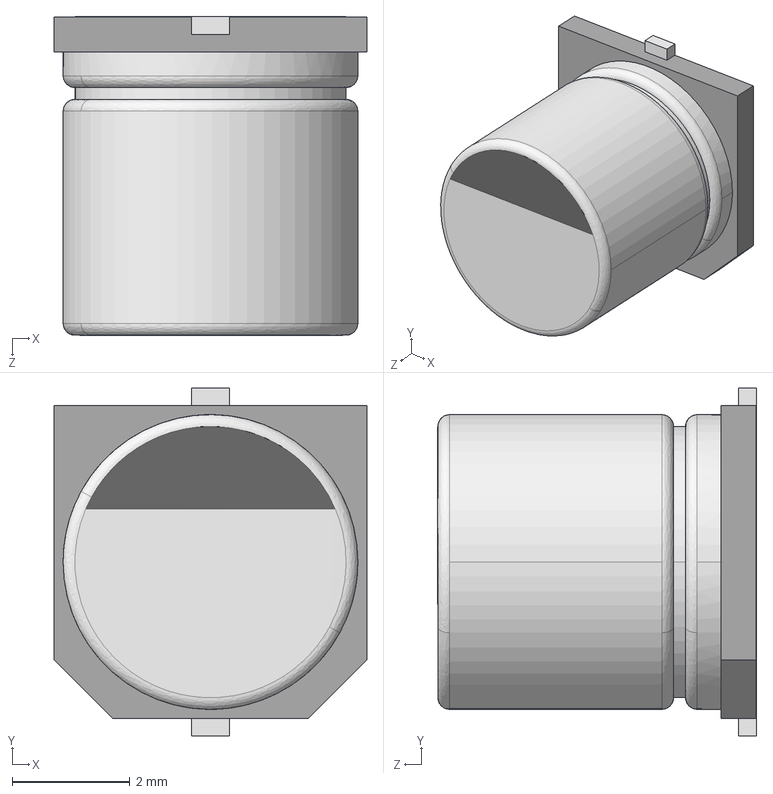
[picture p16: CAD file, 2018-08-29]
User Library-capacitor size C.step
5.30 x 5.90 x 5.41 mm
