sudhanshuksingh/Arduino-28-Pins-PCB/SW3dPS-tqfp32.STEP

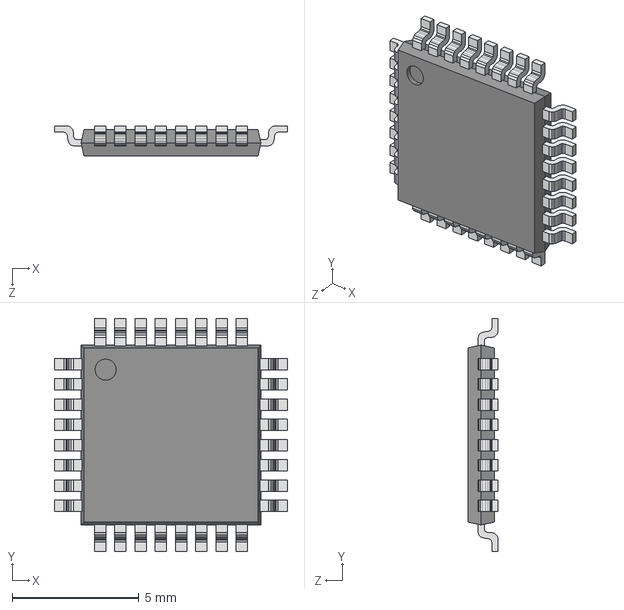
[picture p17: CAD file, 2018-08-29]
SW3dPS-tqfp32.STEP
9.20 x 9.20 x 1.20 mm
