sudhanshuksingh/Arduino-28-Pins-PCB/m20-7820646_asm/m20-7820646_asm.stp

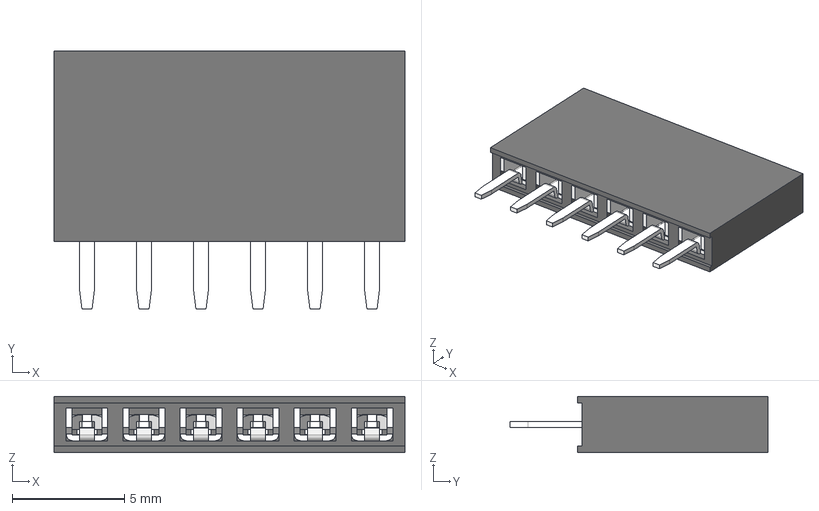
[picture p18: CAD file, 2018-08-29]
m20-7820646_asm/m20-7820646_asm.stp
15.6 x 11.5 x 2.50 mm
M20-78206_MOULD
M20-782_CONTACT x 6
