sudhanshuksingh/Arduino-28-Pins-PCB/m20-7820842_asm/m20-7820842_asm.stp

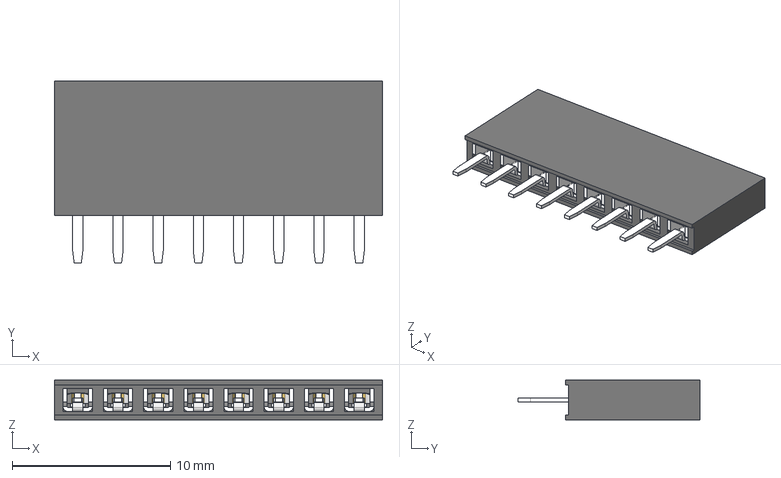
[picture p19: CAD file, 2018-08-29]
m20-7820842_asm/m20-7820842_asm.stp
20.7 x 11.5 x 2.50 mm
M20-78208_MOULD
M20-782_CONTACT x 8
