sudhanshuksingh/Arduino-28-Pins-PCB/(list of files, cad)

Other CAD files:
961204-6404-XX_step/961204-6404-XX.stp
961206-6404-XX_step/961206-6404-XX.stp
m20-7820646_asm/m20-7820646_asm.igs
m20-7820842_asm/m20-7820842_asm.igs
m20-7821046_asm/m20-7821046_asm.igs
m20-7821046_asm/m20-7821046_asm.stp
