sudhanshuksingh/Arduino-28-Pins-PCB/Templates/Templates/!Released Files/Step 5 - Schematic/read_me.txt

Update Schematic Cover Page to RELEASED DD-MMM-YYYY
Place here PDF version of schematic, if possible one for each BOM variant.
