sudhanshuksingh/Arduino-28-Pins-PCB/Project Outputs for 28Pins_Project_V1I1/Top View Drawing - 28Pins V1I1 - No Variant.PDF

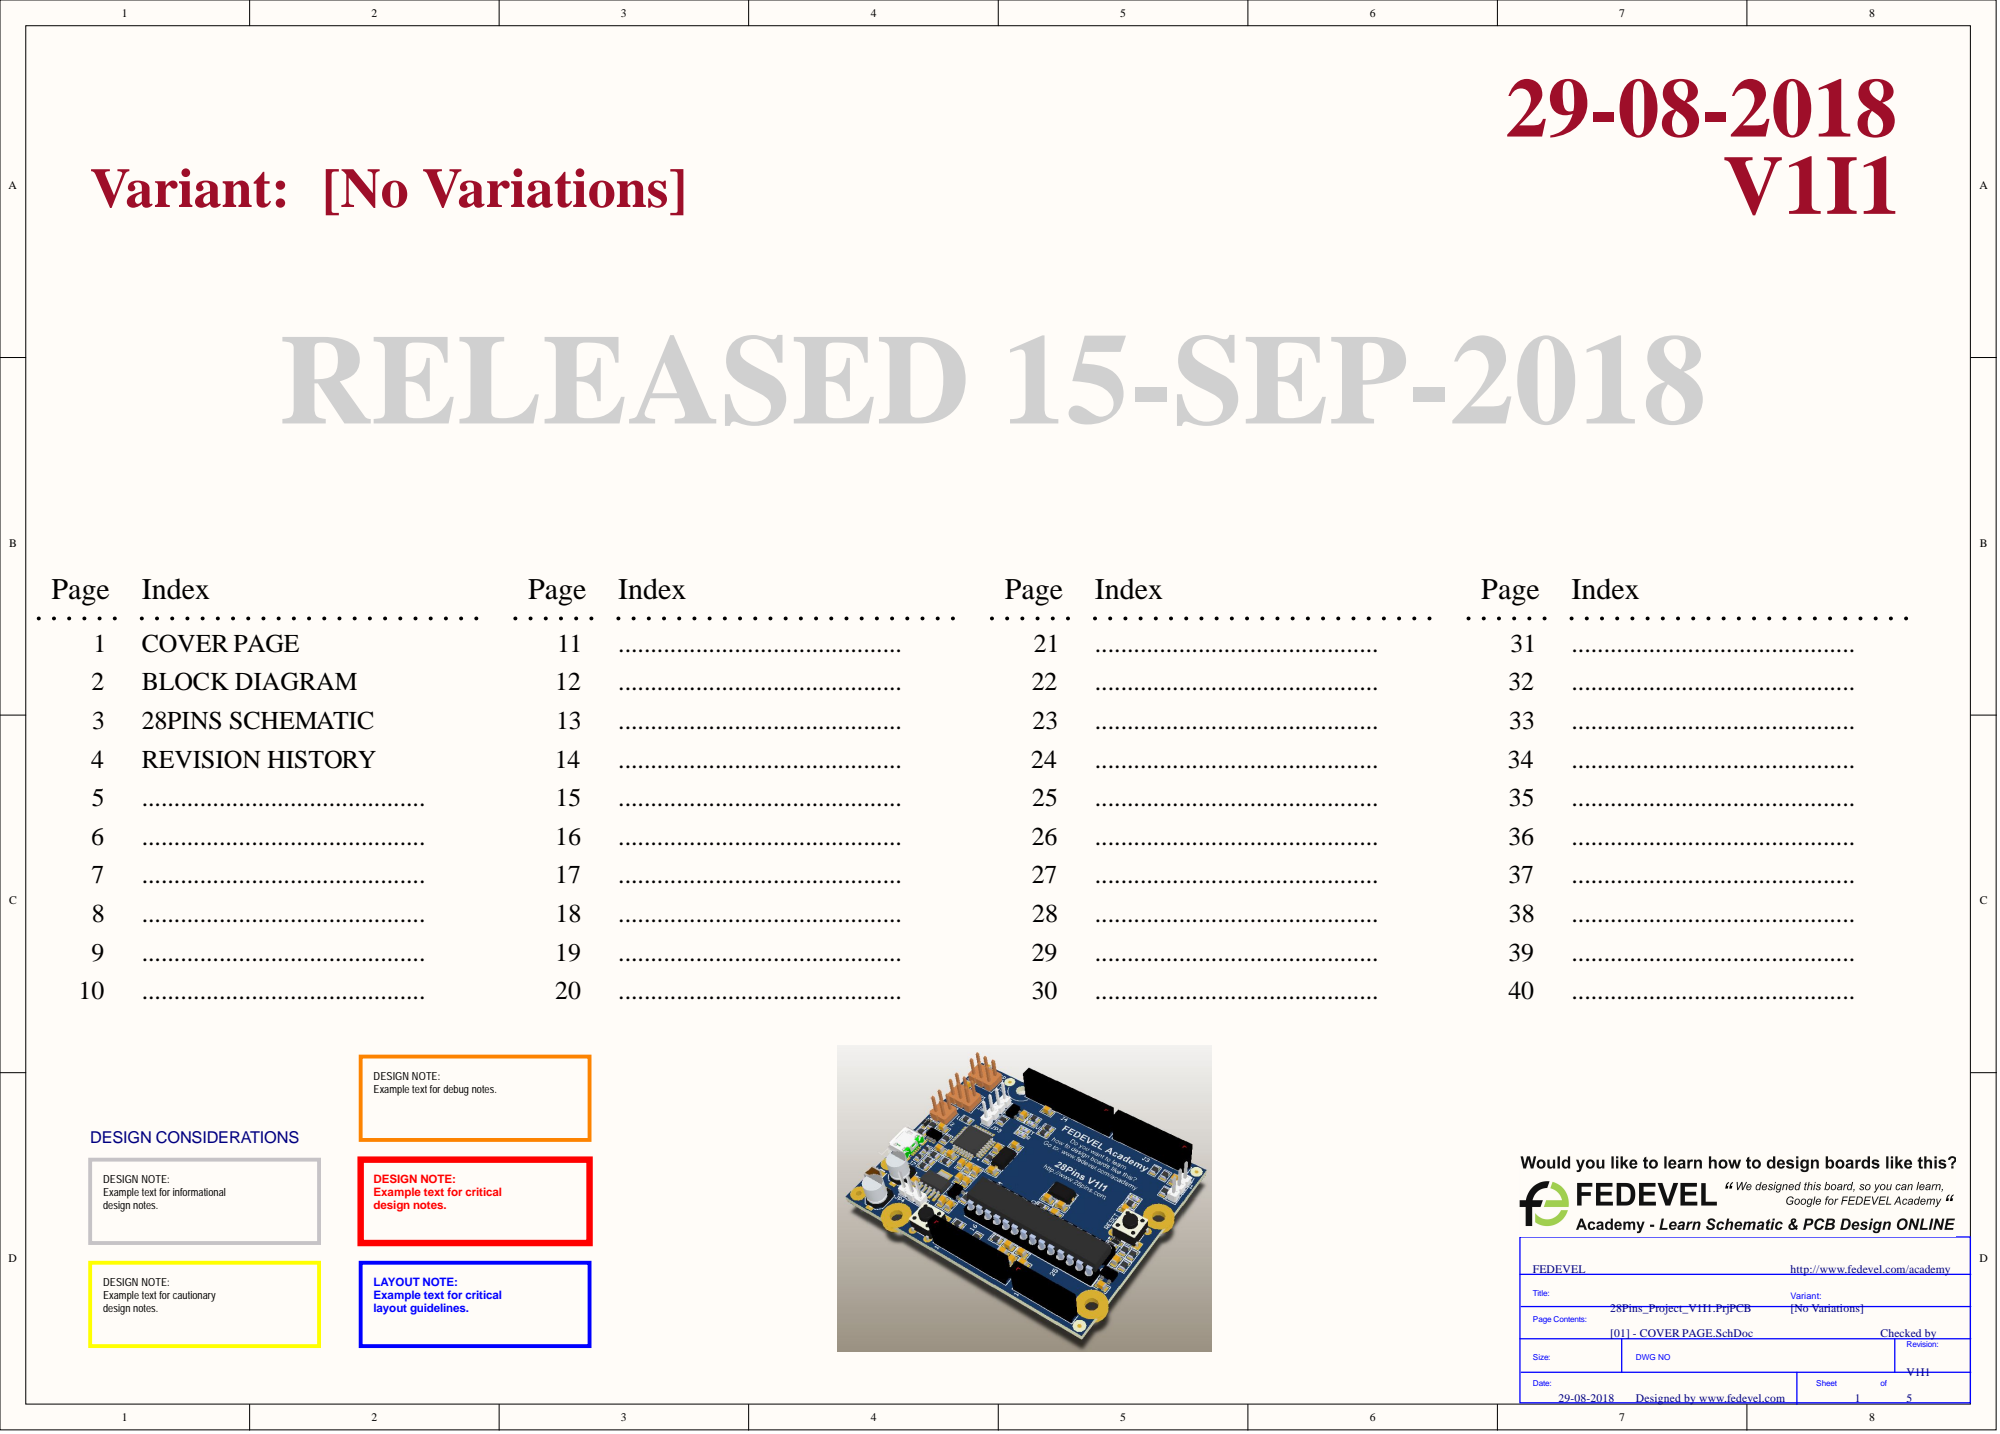
[picture p30: page 1]

DESIGN NOTE:
Example text for debug notes.

Example text for informational
design notes.

Example text for critical

http://www.fedevel.com/academy

Example text for cautionary

LAYOUT NOTE:
layout guidelines.

Size: | DWG NO | Revision:

Date: 29-08-2018 Designed by www.fedevel.com | Sheet of

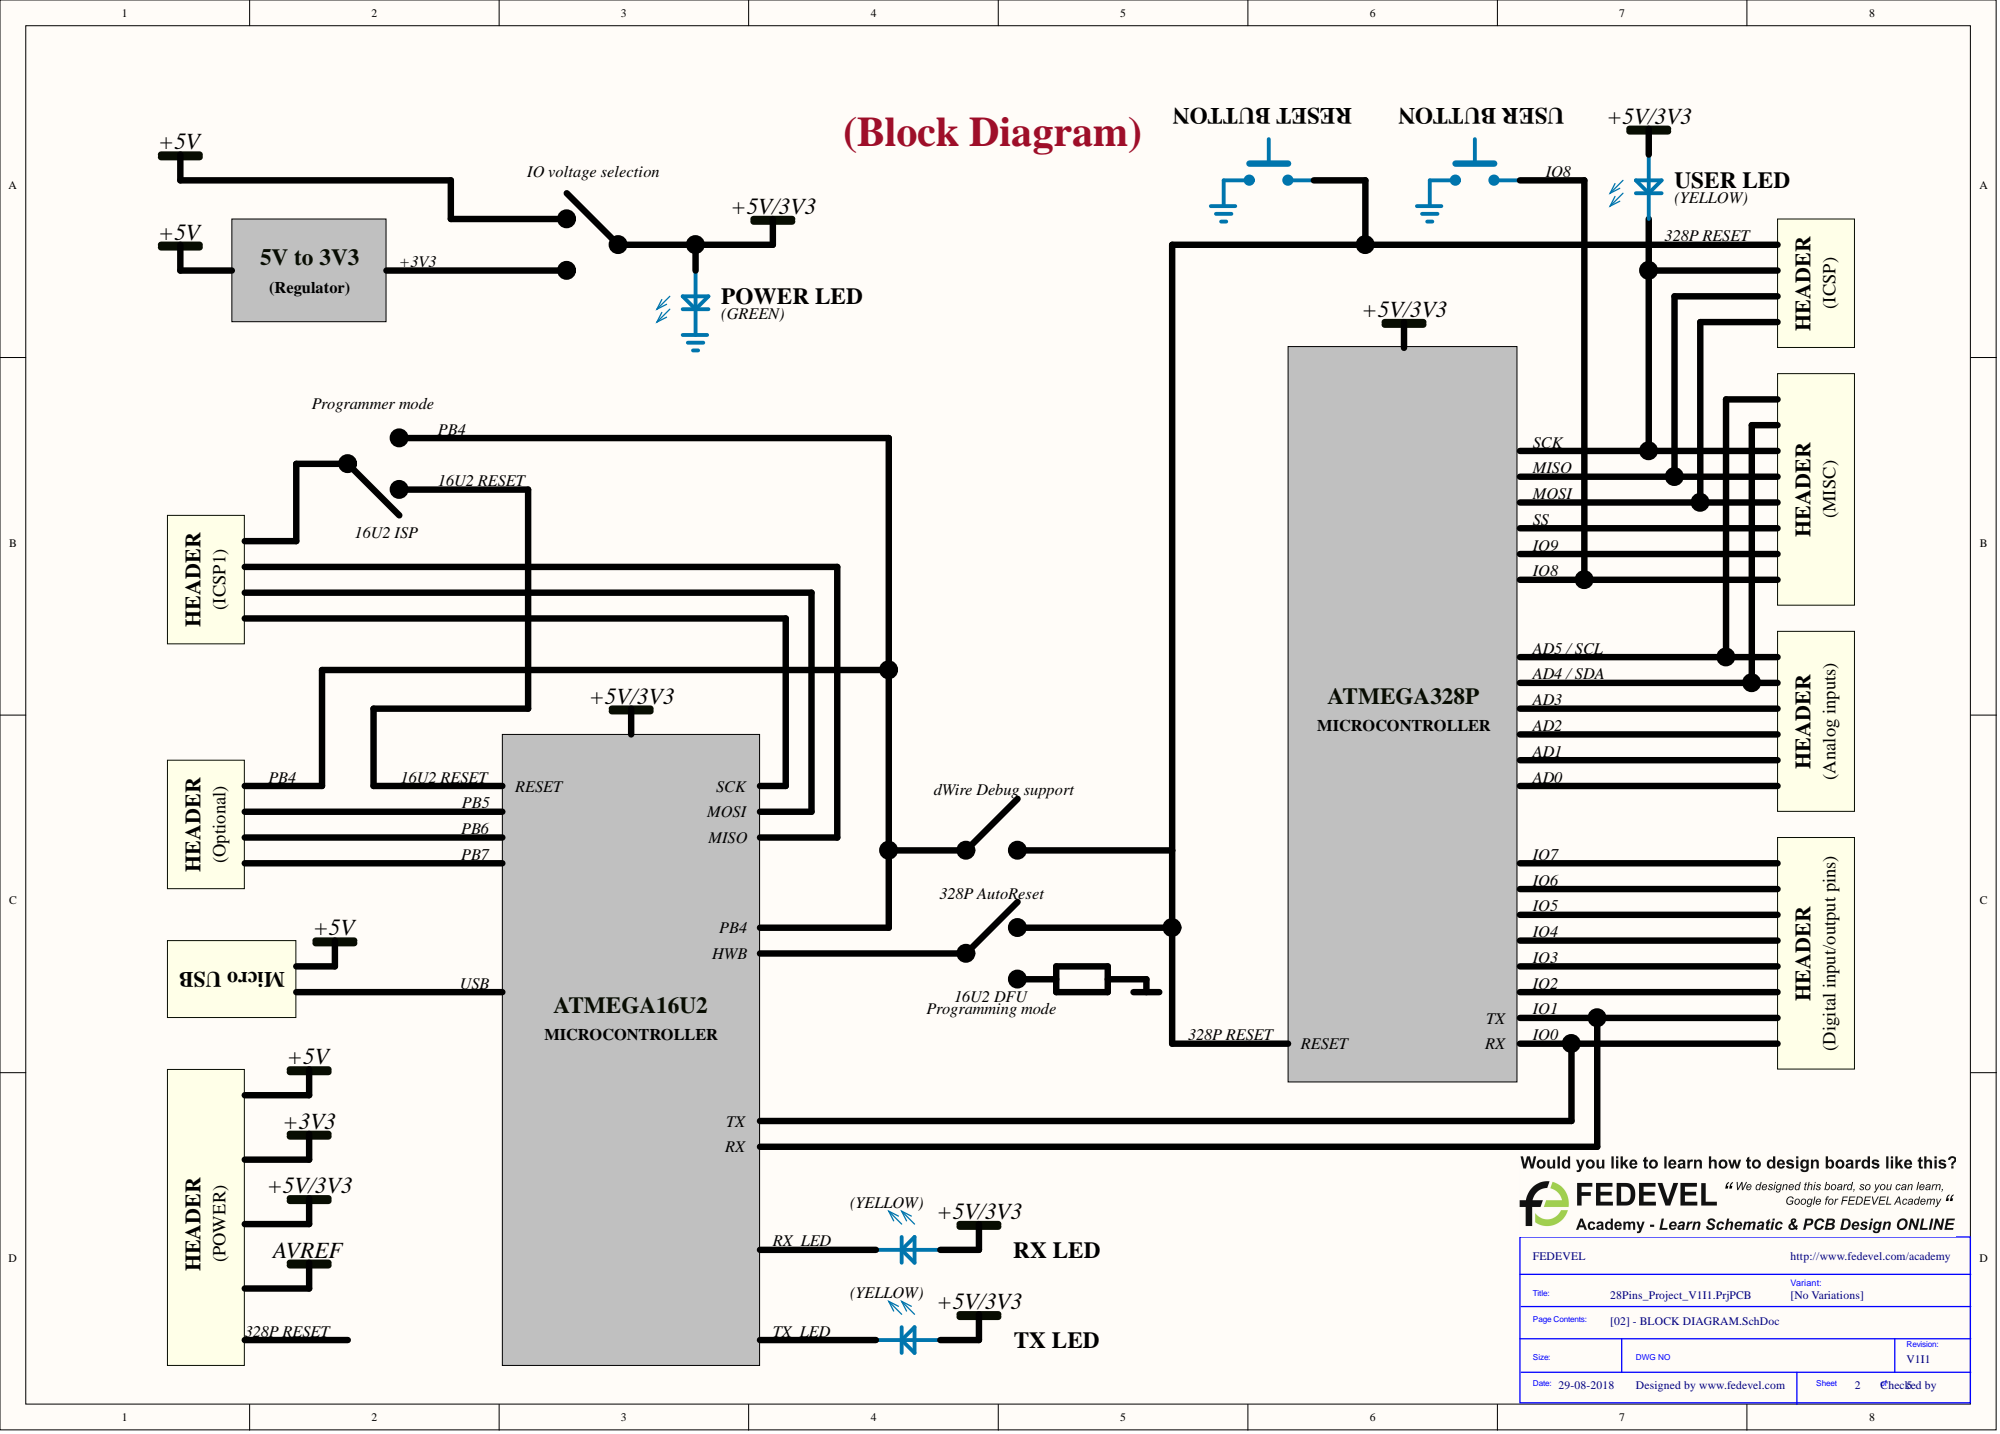
[picture p31: page 2]

MISO
MOSI
SS
IO9
IO8

AD5 / SCL
AD4 / SDA

http://www.fedevel.com/academy

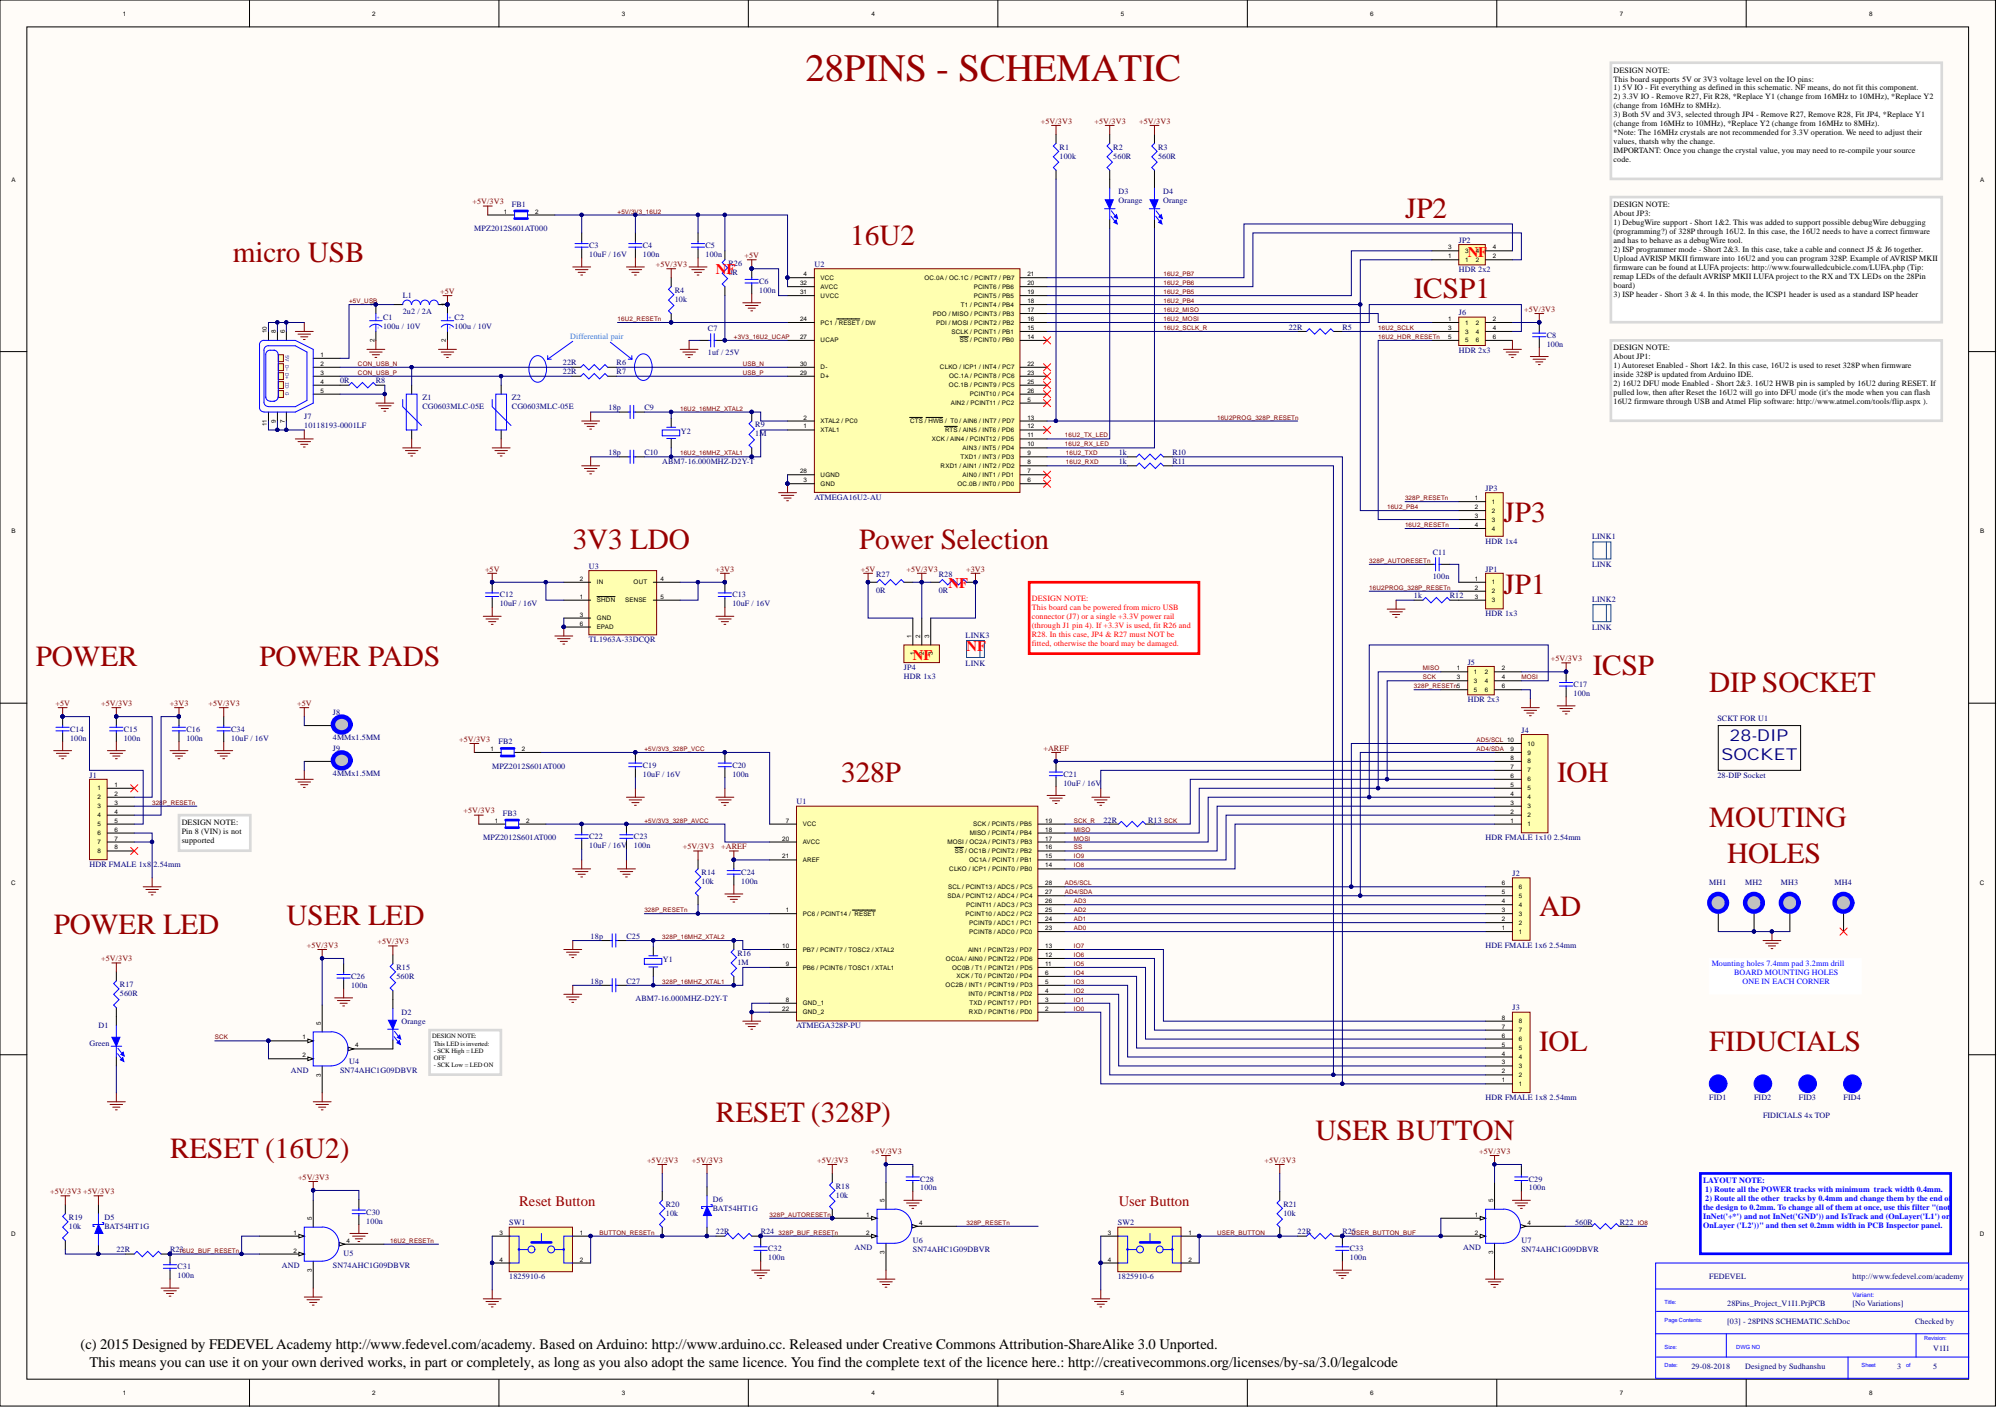
[picture p32: page 3]

DESIGN NOTE:
This board supports 5V or 3V3 voltage level on the IO pins:
1) 5V IO - Fit everything as defined in this schematic. NF means, do not fit this component.
2) 3.3V IO - Remove R27, Fit R28, *Replace Y1 (change from 16MHz to 10MHz), *Replace Y2
(change from 16MHz to 8MHz).
3) Both 5V and 3V3, selected through JP4 - Remove R27, Remove R28, Fit JP4, *Replace Y1
(change from 16MHz to 10MHz), *Replace Y2 (change from 16MHz to 8MHz).
*Note: The 16MHz crystals are not recommended for 3.3V operation. We need to adjust their
values, thatsh why the change.
IMPORTANT: Once you change the crystal value, you may need to re-compile your source
code.

About JP3:
1) DebugWire support - Short 1&2. This was added to support possible debugWire debugging
(programming?) of 328P through 16U2. In this case, the 16U2 needs to have a correct firmware
and has to behave as a debugWire tool.
2) ISP programmer mode - Short 2&3. In this case, take a cable and connect J5 & J6 together.
Upload AVRISP MKII firmware into 16U2 and you can program 328P. Example of AVRISP MKII
firmware can be found at LUFA projects: http://www.fourwalledcubicle.com/LUFA.php (Tip:
remap LEDs of the default AVRISP MKII LUFA project to the RX and TX LEDs on the 28Pin
board)
3) ISP header - Short 3 & 4. In this mode, the ICSP1 header is used as a standard ISP header

16U2_PB7
16U2_PB6 | ICSP1

UVCC 31 AVCC 32 | | | | 16U2_PB5

16U2_MISO | J6
16U2_MOSI

+3V3_16U2_UCAP | UCAP 27 | | 16U2_SCLK_R 22R R5 16U2PROG_328P_RESETn | 16U2_SCLK

About JP1:
1) Autoreset Enabled - Short 1&2. In this case, 16U2 is used to reset 328P when firmware
inside 328P is updated from Arduino IDE.
2) 16U2 DFU mode Enabled - Short 2&3. 16U2 HWB pin is sampled by 16U2 during RESET. If
pulled low, then after Reset the 16U2 will go into DFU mode (it's the mode when you can flash
16U2 firmware through USB and Atmel Flip software: http://www.atmel.com/tools/flip.aspx ).

This board can be powered from micro USB
connector (J7) or a single +3.3V power rail
(through J1 pin 4). If +3.3V is used, fit R26 and
R28. In this case, JP4 & R27 must NOT be
fitted, otherwise the board may be damaged.

Pin 8 (VIN) is not
supported

PC6 / PCINT14 / RESET 1 | | IO8

AD5/SCL
AD4/SDA

PB7 / PCINT7 / TOSC2 / XTAL2 10 | AD1

Mounting holes 7.4mm pad 3.2mm drill
BOARD MOUNTING HOLES
ONE IN EACH CORNER

GND_1 8 | IO4

GND_2 22 | IO0

This LED is inverted:
- SCK High = LED
OFF
- SCK Low = LED ON

LAYOUT NOTE:
1) Route all the POWER tracks with minimum track width 0.4mm.
2) Route all the other tracks by 0.4mm and change them by the end of
the design to 0.2mm. To change all of them at once, use this filter "(not
InNet('+*') and not InNet('GND')) and IsTrack and (OnLayer('L1') or
OnLayer ('L2'))" and then set 0.2mm width in PCB Inspector panel.

http://www.fedevel.com/academy

(c) 2015 Designed by FEDEVEL Academy http://www.fedevel.com/academy. Based on Arduino: http://www.arduino.cc. Released under Creative Commons Attribution-ShareAlike 3.0 Unported.
This means you can use it on your own derived works, in part or completely, as long as you also adopt the same licence. You find the complete text of the licence here.: http://creativecommons.org/licenses/by-sa/3.0/legalcode

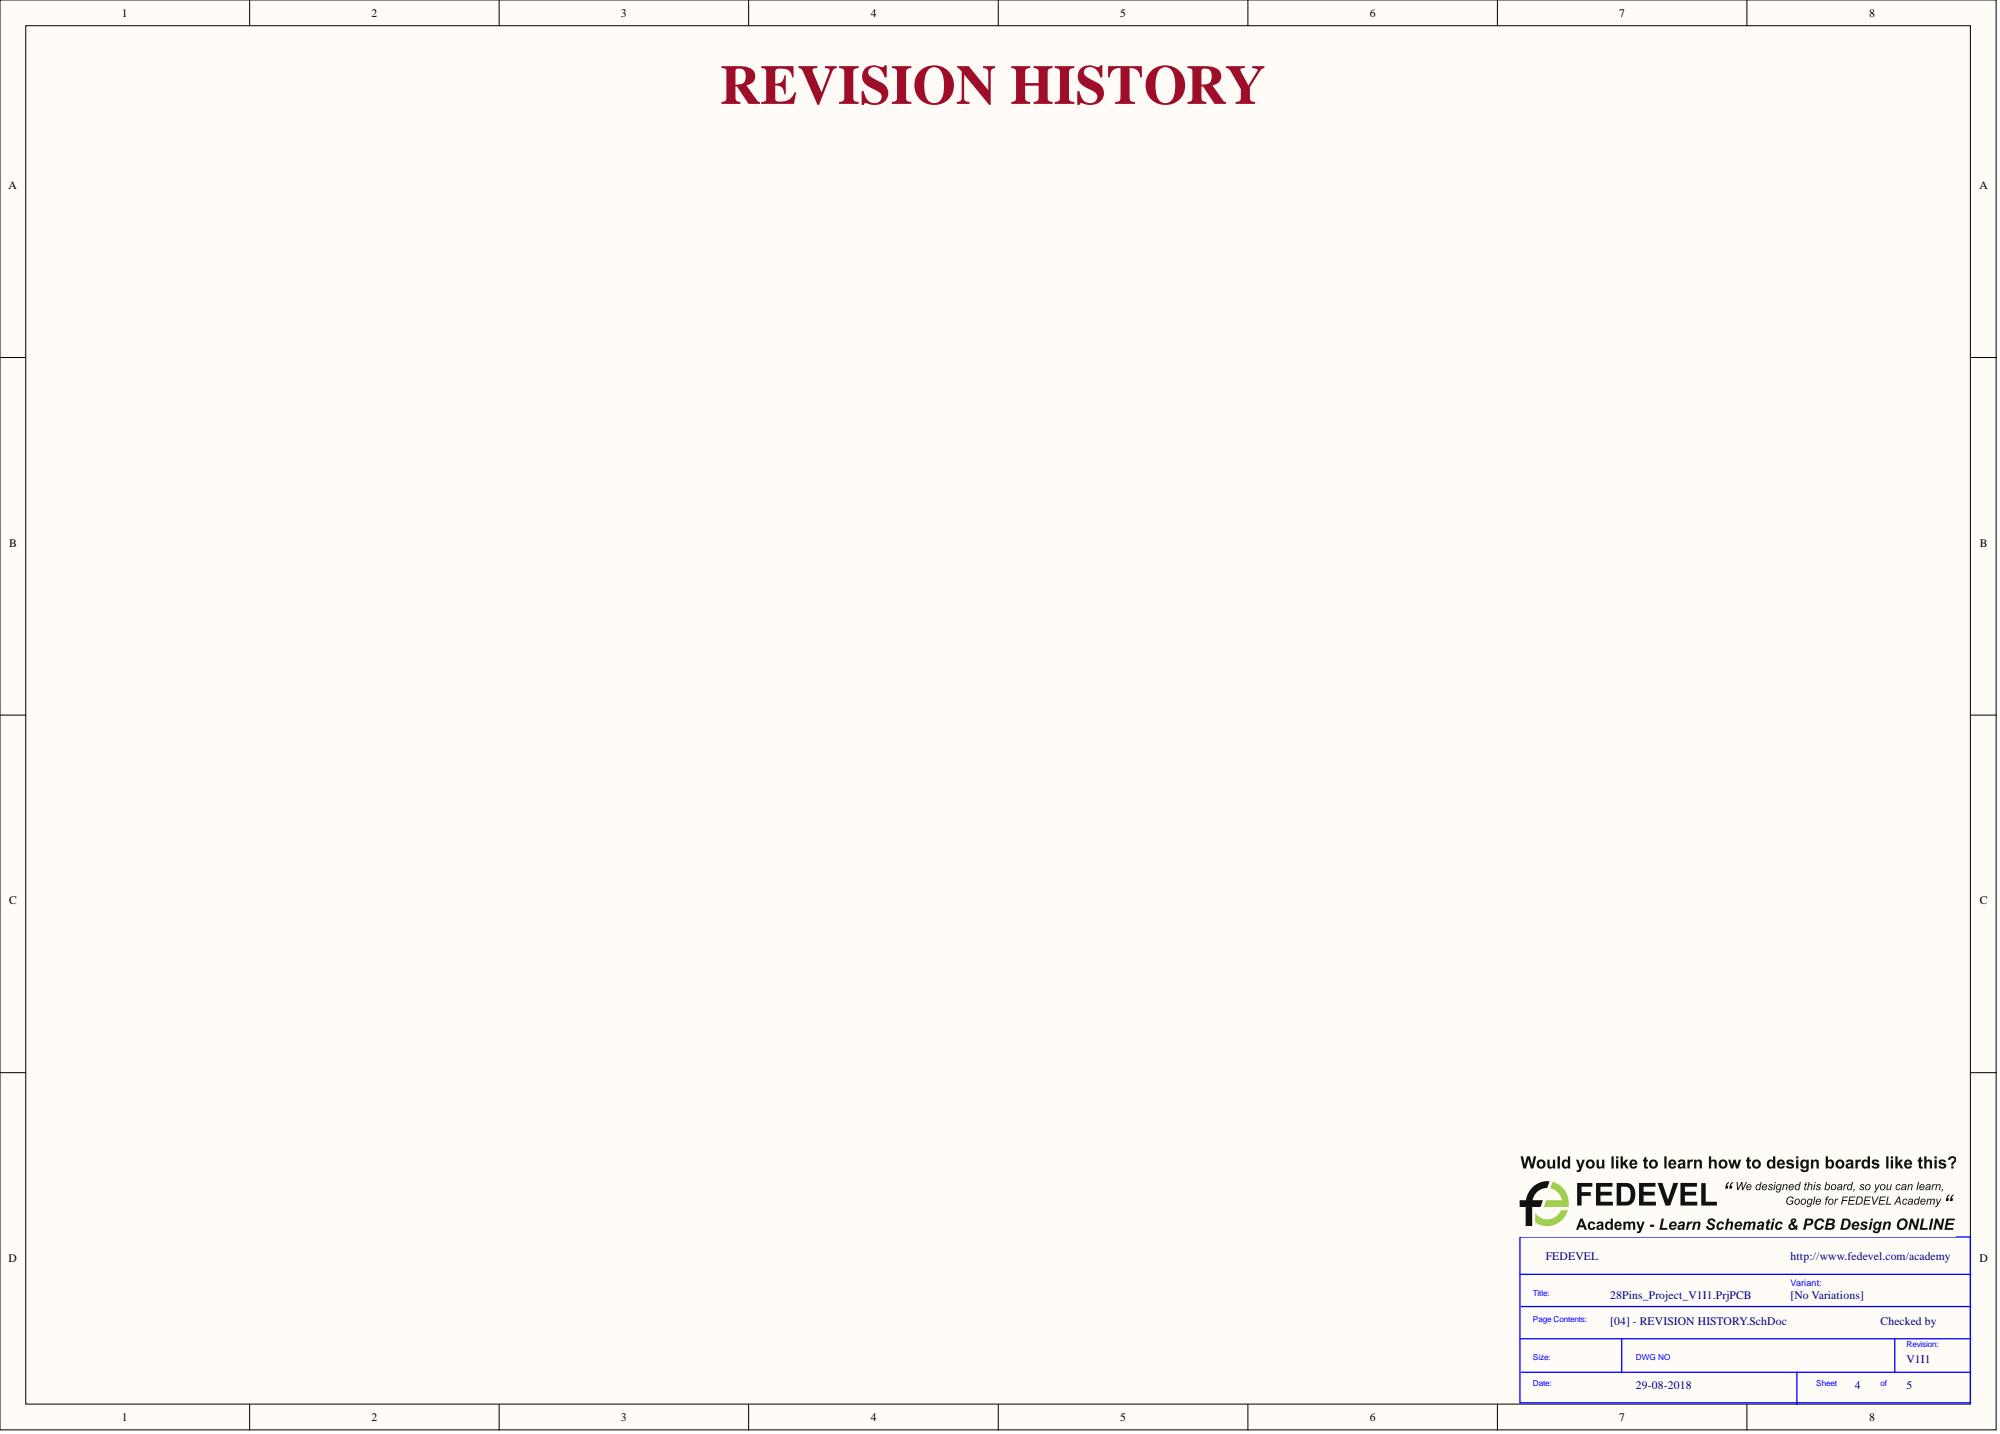
[picture p33: page 4]

http://www.fedevel.com/academy

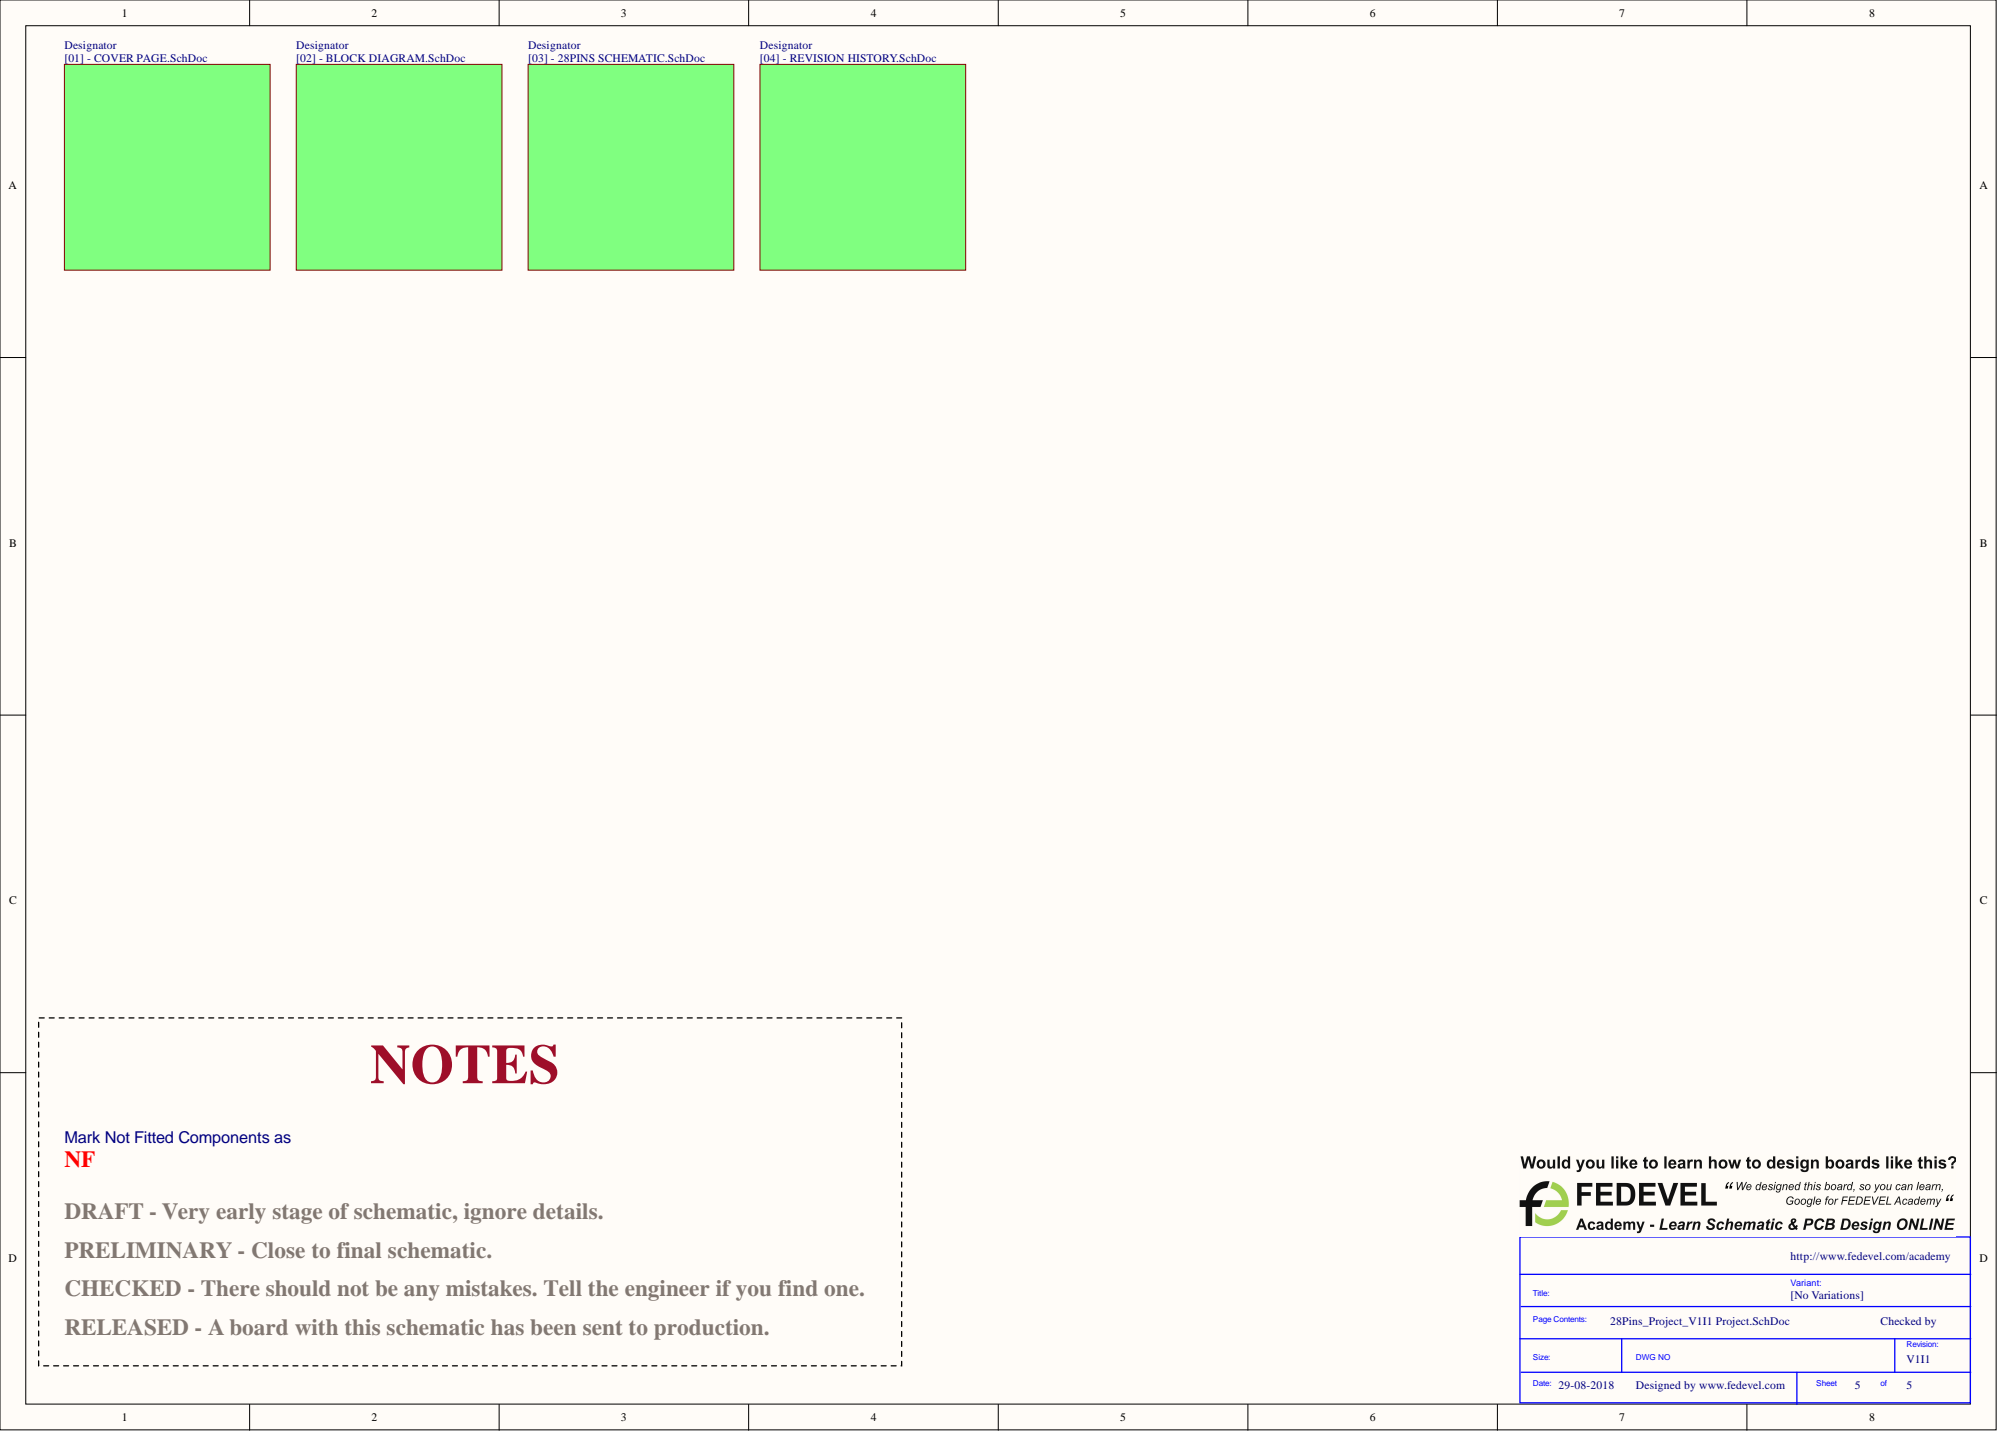
[picture p34: page 5]

Mark Not Fitted Components as

DRAFT - Very early stage of schematic, ignore details.
PRELIMINARY - Close to final schematic.
CHECKED - There should not be any mistakes. Tell the engineer if you find one.
RELEASED - A board with this schematic has been sent to production.

http://www.fedevel.com/academy

Designed by www.fedevel.com
