sudhanshuksingh/Arduino-28-Pins-PCB/Project Outputs for 28Pins_Project_V1I1/28Pins Mechanical Drawing.pdf

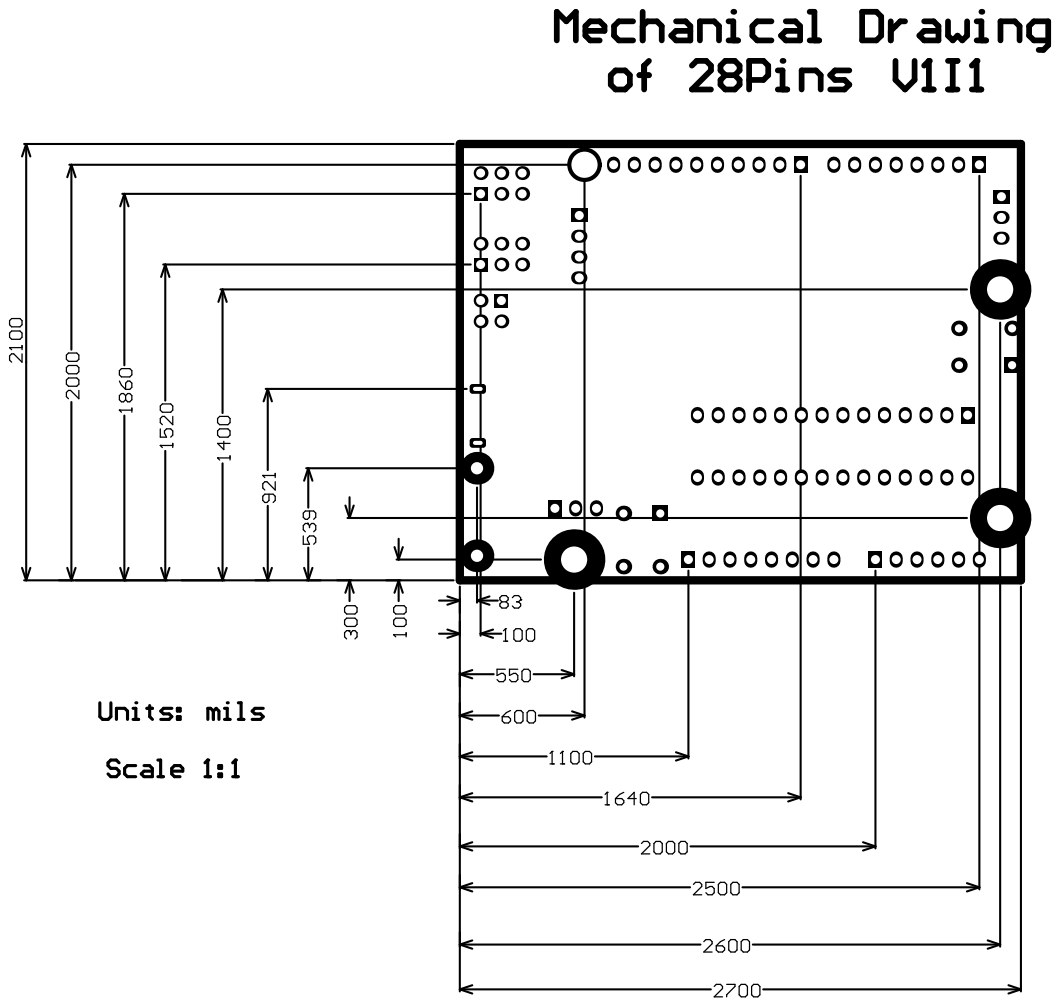
[picture p35: page 1]
