sudhanshuksingh/Arduino-28-Pins-PCB/Project Outputs for 28Pins_Project_V1I1/Assembly Drawing - 28Pins V1I1 - 5V and 3V3.PDF

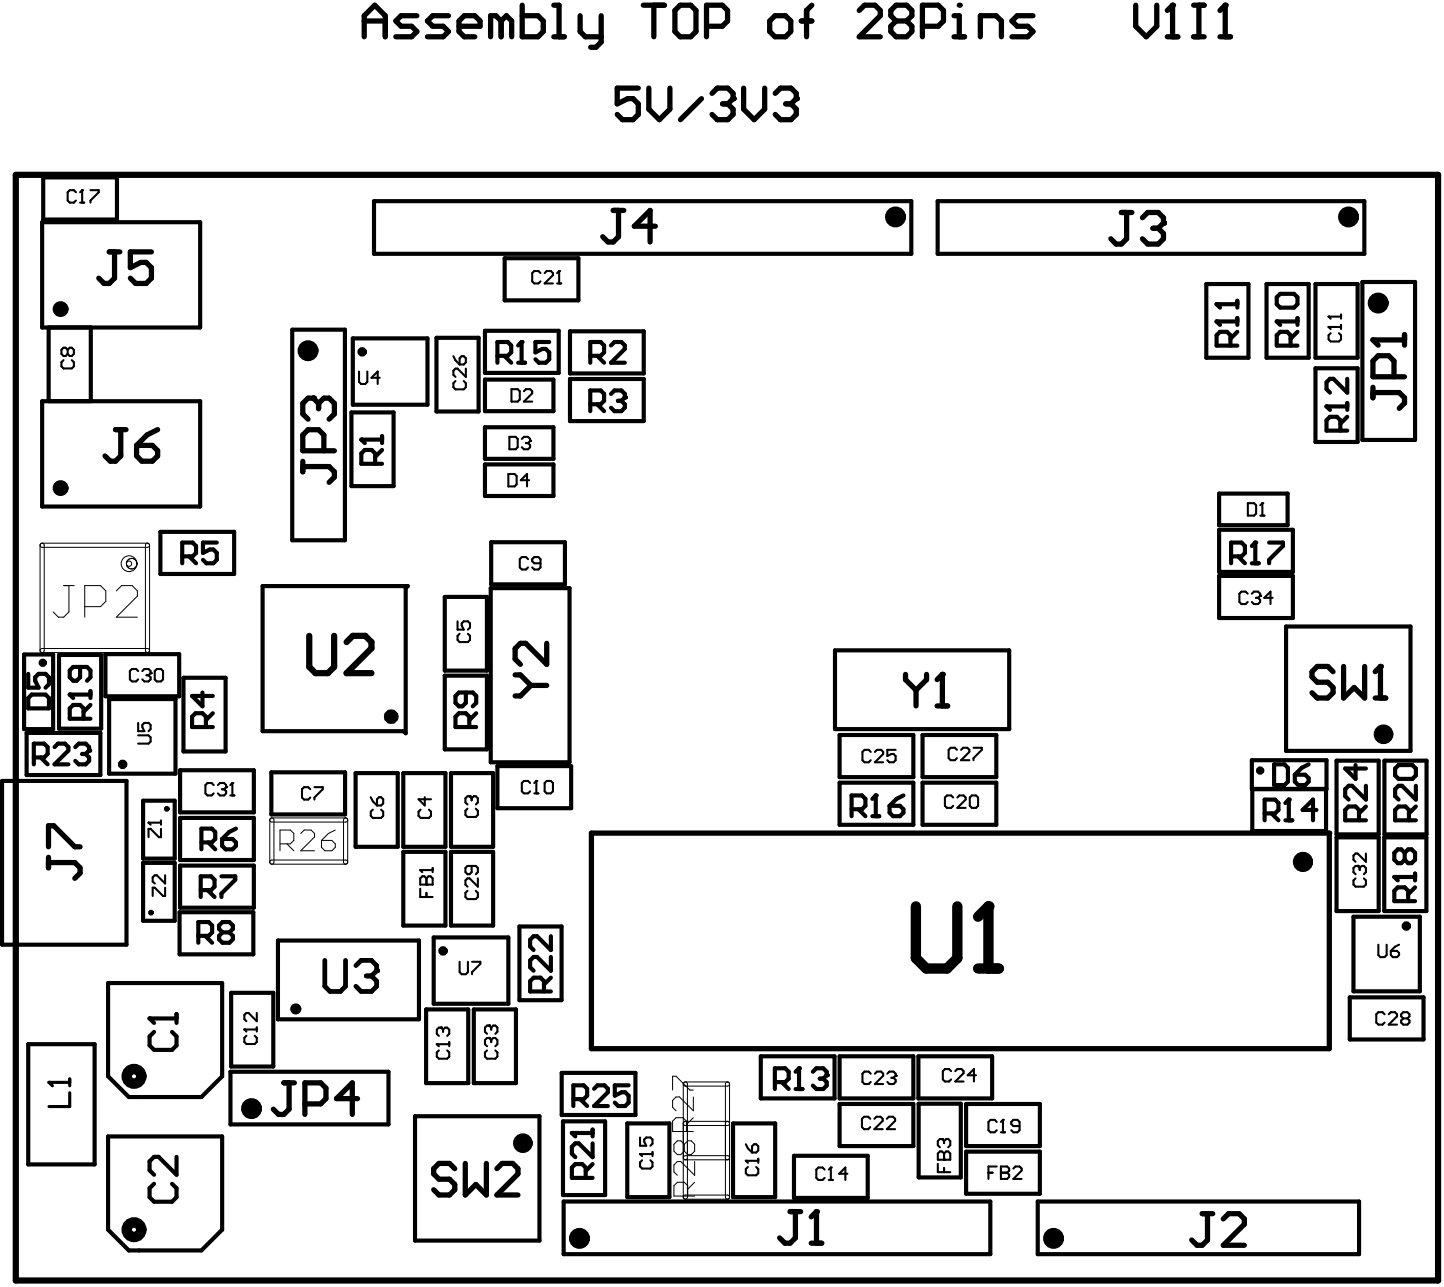
[picture p36: page 1]
