sudhanshuksingh/Arduino-28-Pins-PCB/Project Outputs for 28Pins_Project_V1I1/Assembly Drawing - 28Pins V1I1 - Fixed 5V.PDF

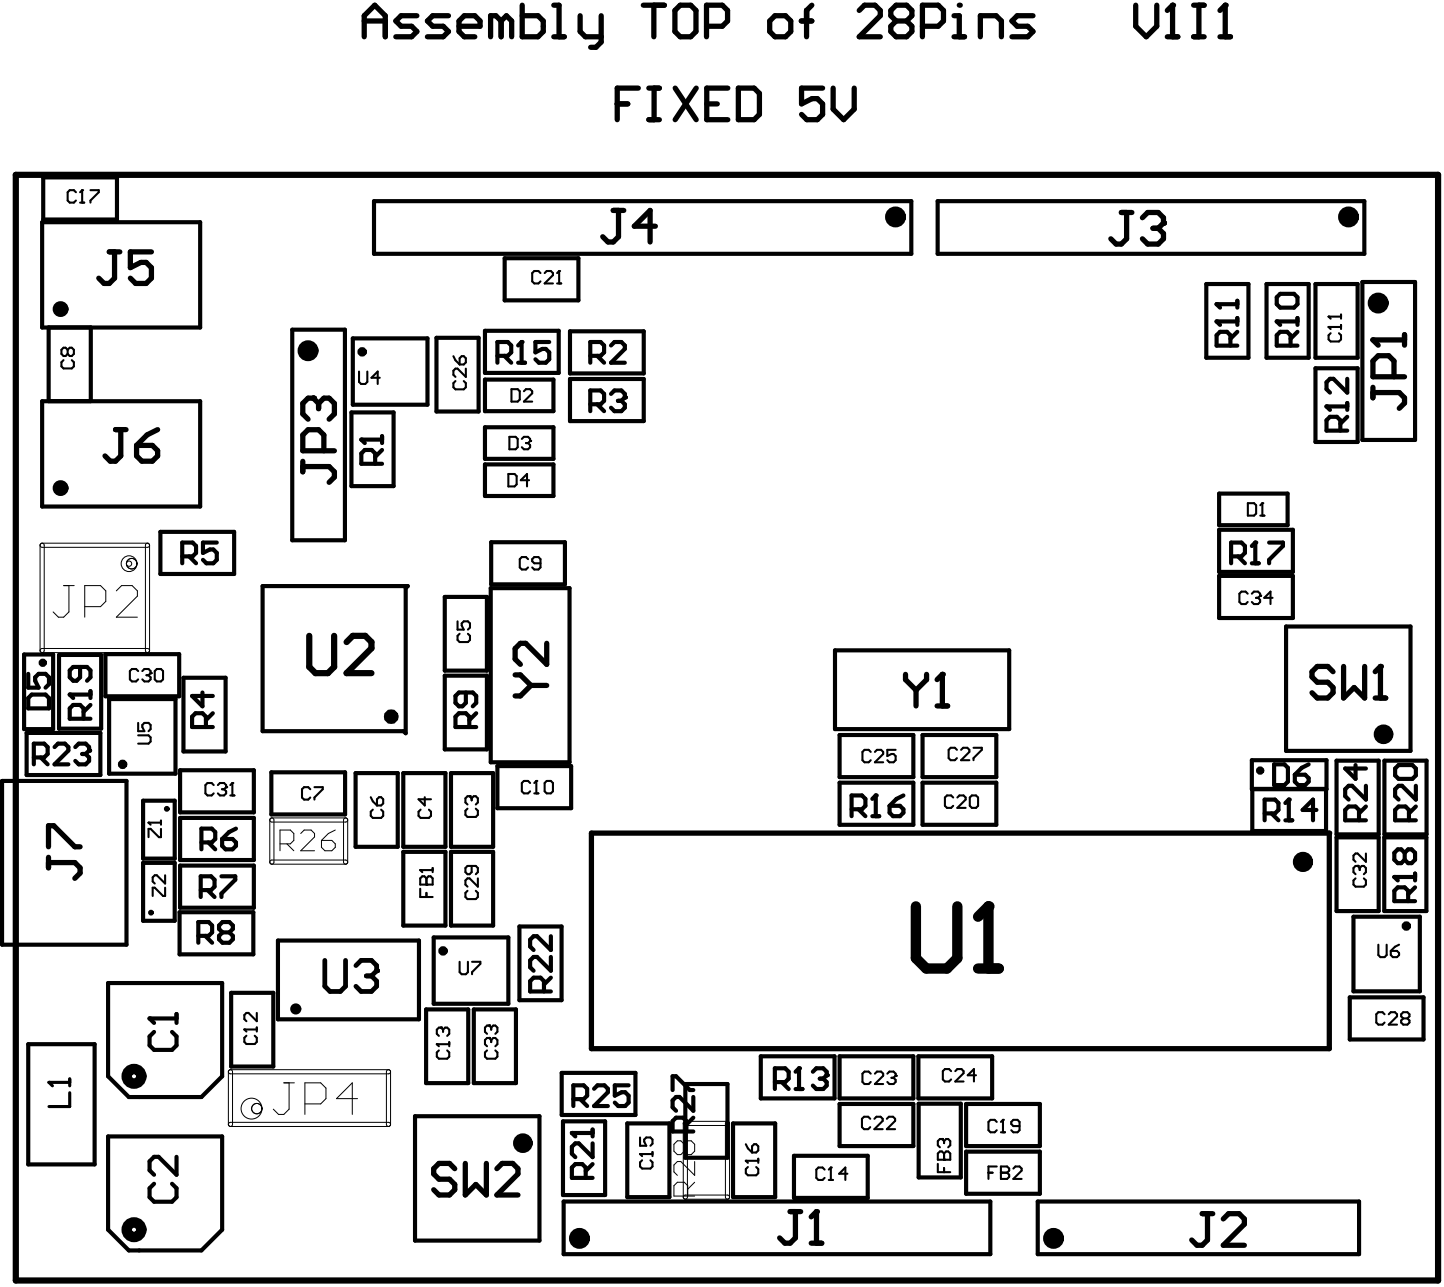
[picture p37: page 1]
