sudhanshuksingh/Arduino-28-Pins-PCB/28Pins Library Check.pdf

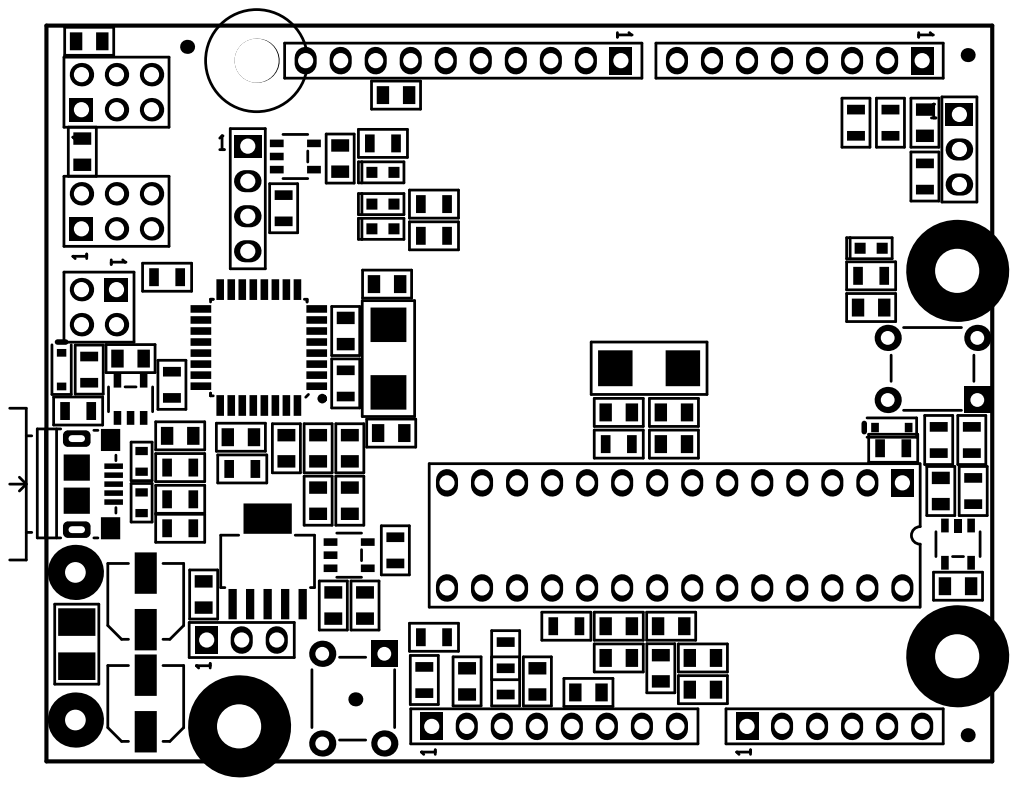
[picture p38: page 1]

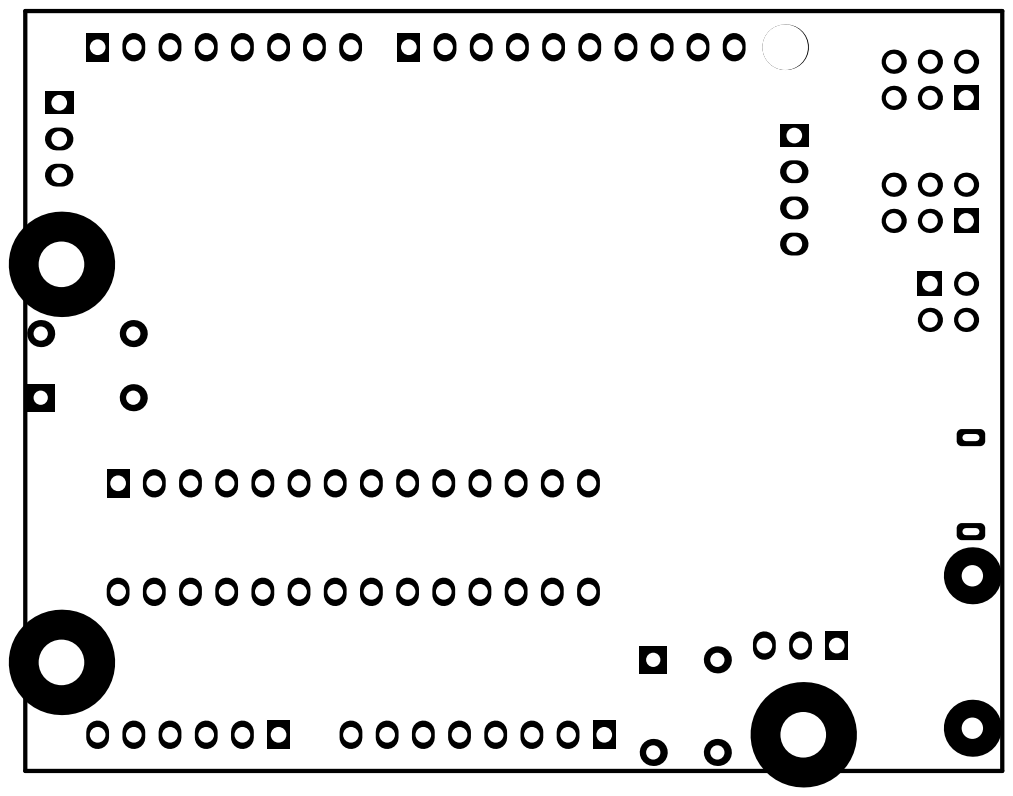
[picture p39: page 2]
