sudhanshuksingh/Arduino-28-Pins-PCB/Project Outputs for 28Pins_Project_V1I1/28Pins Drill Drawing.PDF

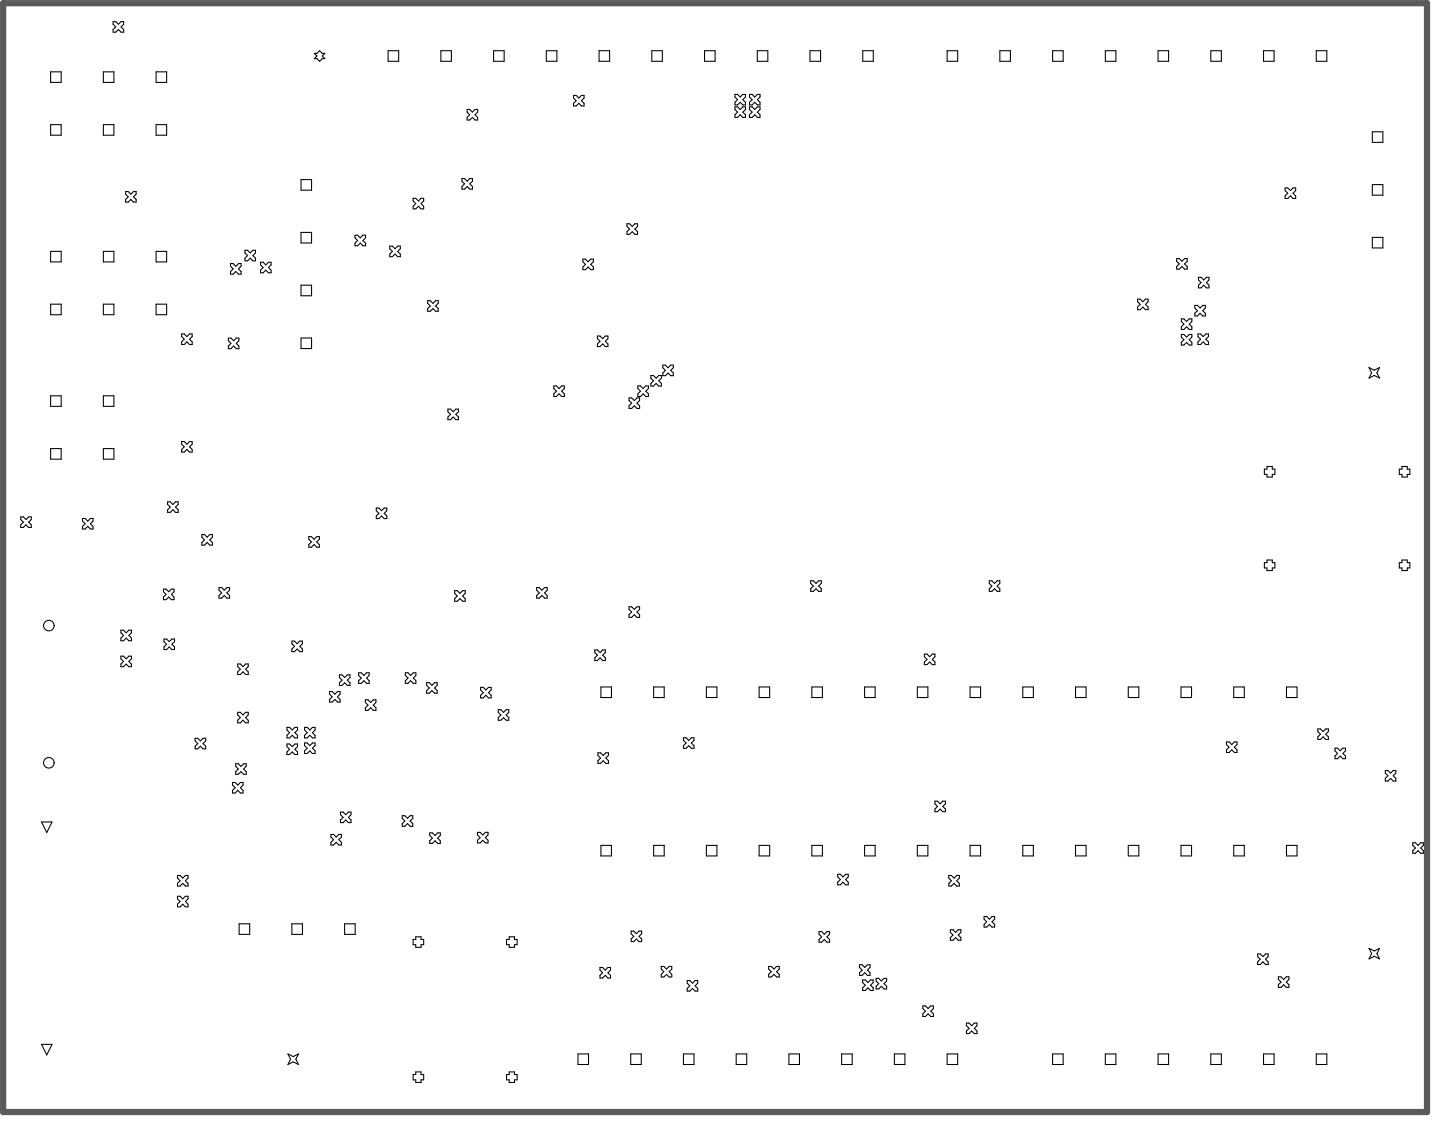
[picture p40: page 1]

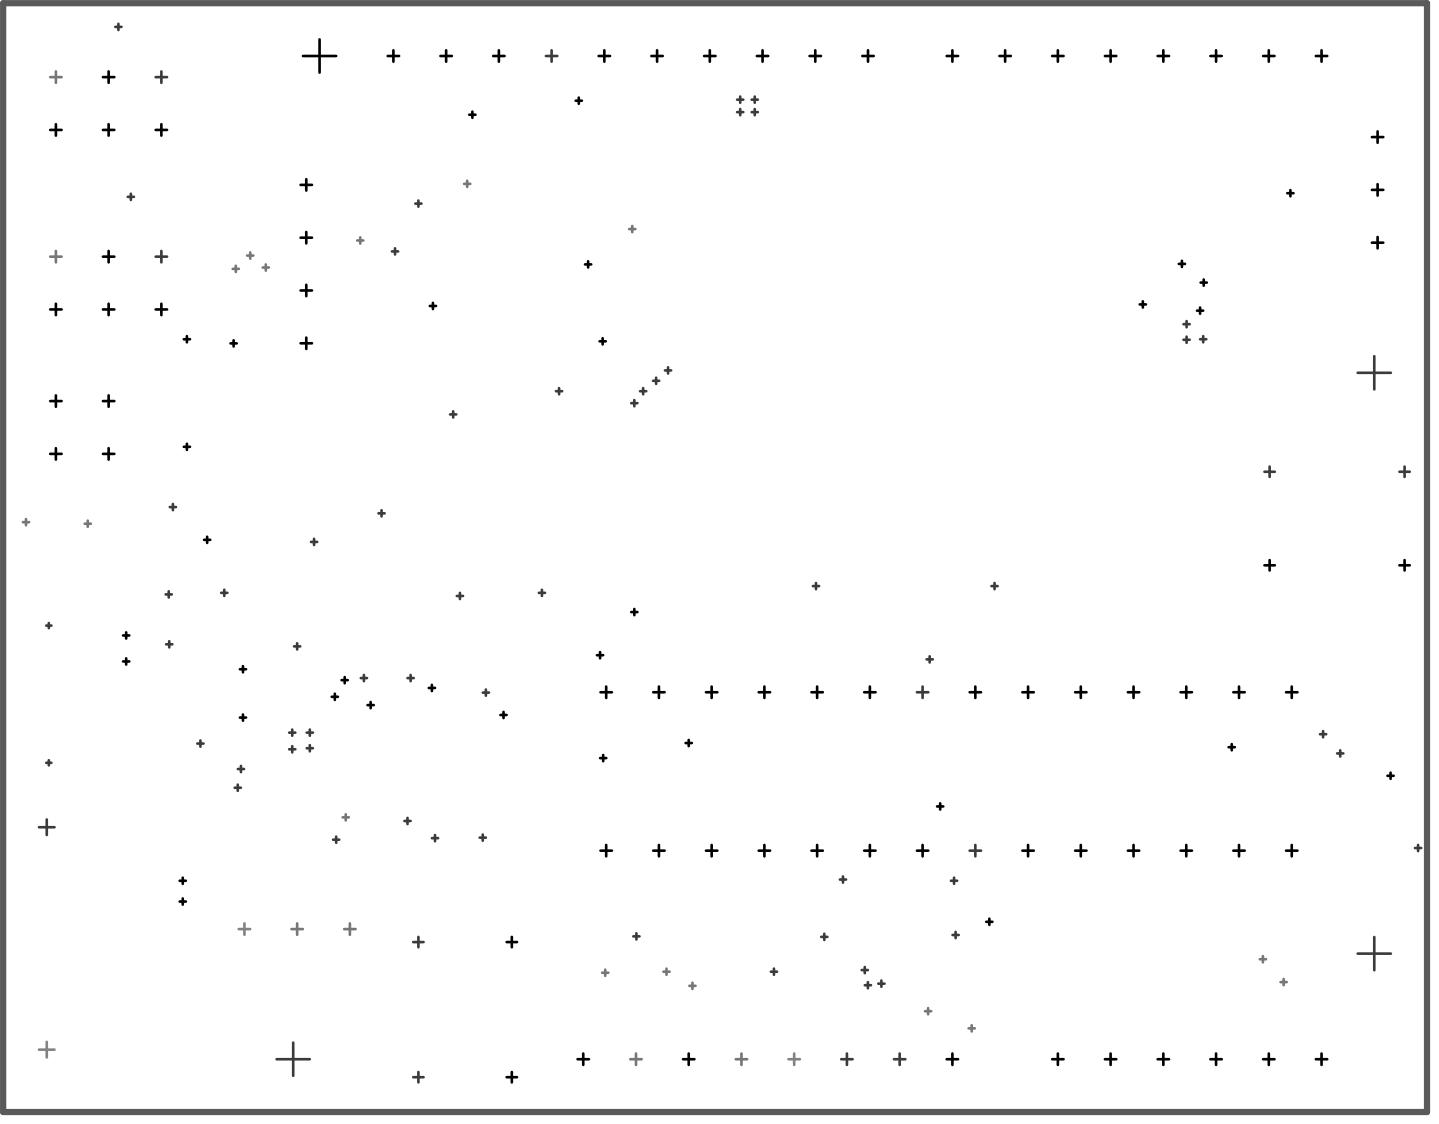
[picture p41: page 2]
