sudhanshuksingh/Arduino-28-Pins-PCB/Project Outputs for 28Pins_Project_V1I1/Top View Drawing - 28Pins V1I1 - 5V and 3V3.PDF

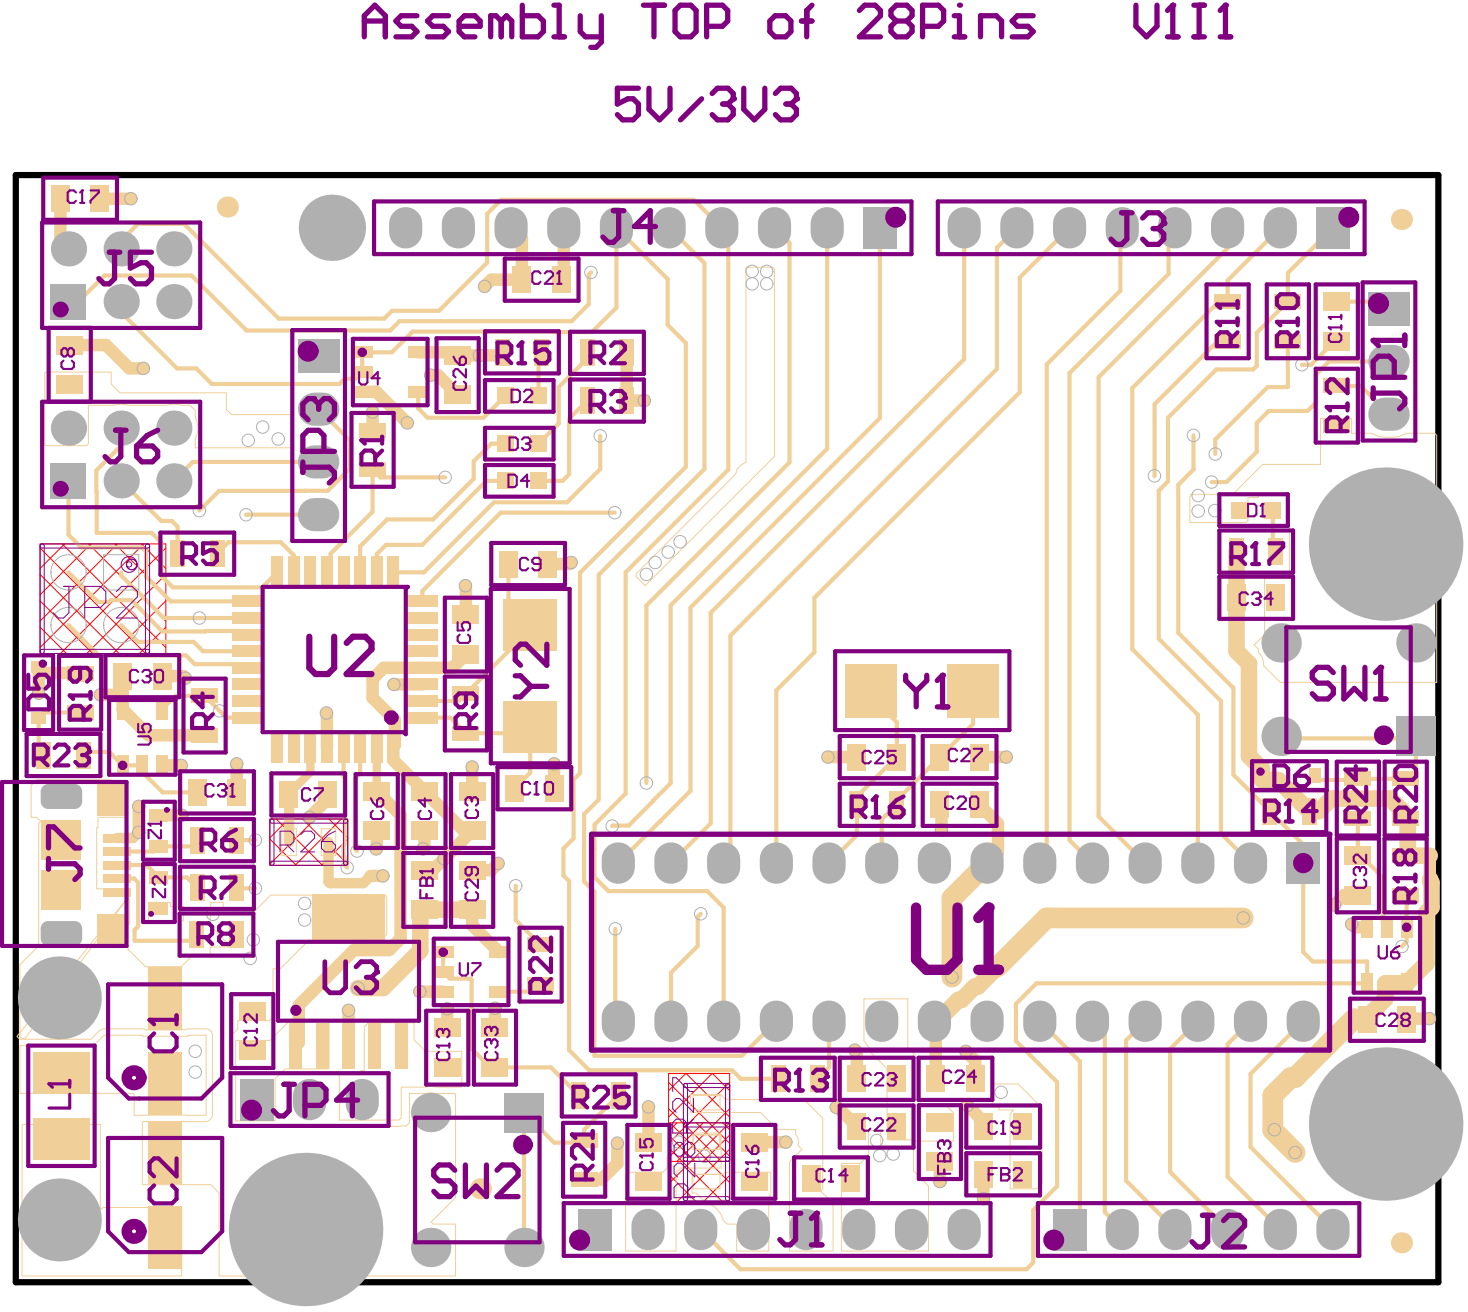
[picture p42: page 1]
