sudhanshuksingh/Arduino-28-Pins-PCB/Project Outputs for 28Pins_Project_V1I1/Top View Drawing - 28Pins V1I1 - Fixed 5V.PDF

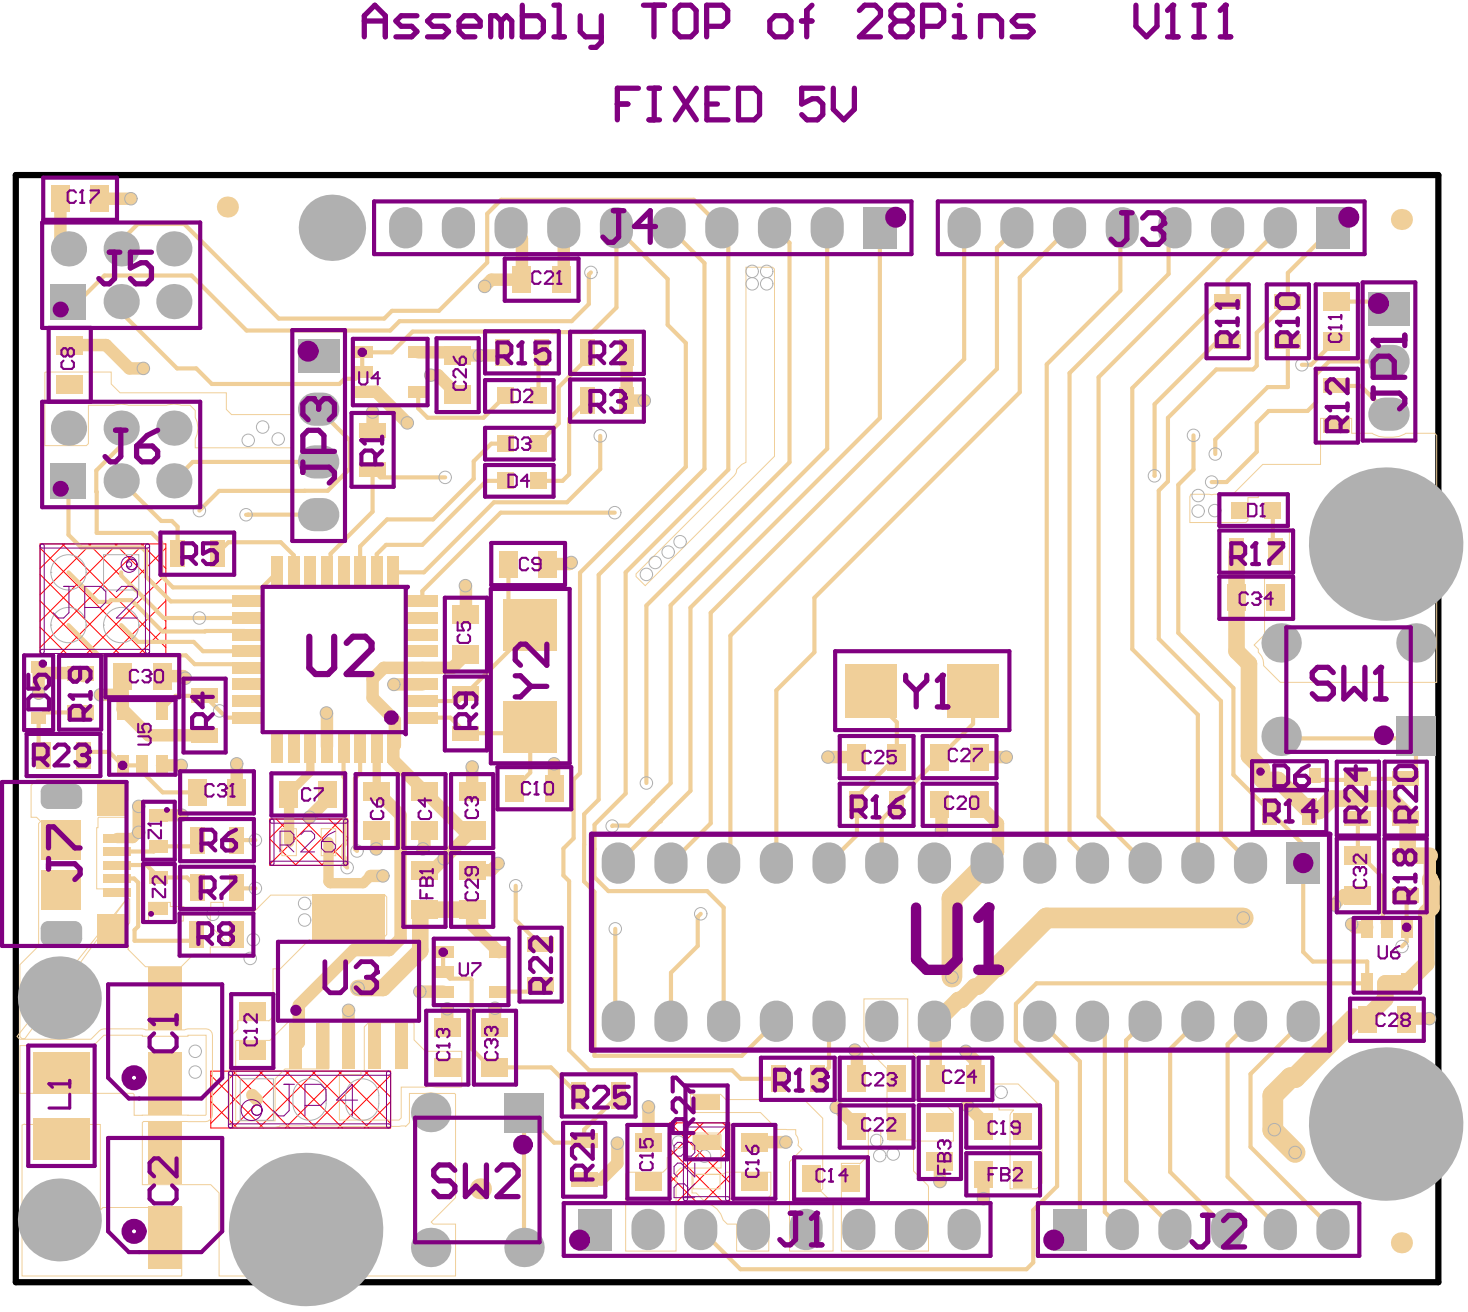
[picture p43: page 1]
