sudhanshuksingh/Arduino-28-Pins-PCB/(list of files, drawings)

Other design files:
28Pins_Project_V1I1 Project.SchDoc
28Pins_Project_V1I1.PcbLib
28Pins_Project_V1I1.PrjPCB
28Pins_Project_V1I1.SchLib
[01] - COVER PAGE.SchDoc
[02] - BLOCK DIAGRAM.SchDoc
[03] - 28 PINS SCHEMATIC.SchDoc
[03] - 28PINS SCHEMATIC.SchDoc
[03] - 28Pins_Schematic.SchDoc
[04] - REVISION HISTORY.SchDoc
